NSLS-II/nsls2em-fpga/doc/xbpm_picozed_revD_sch.pdf

# Channel A

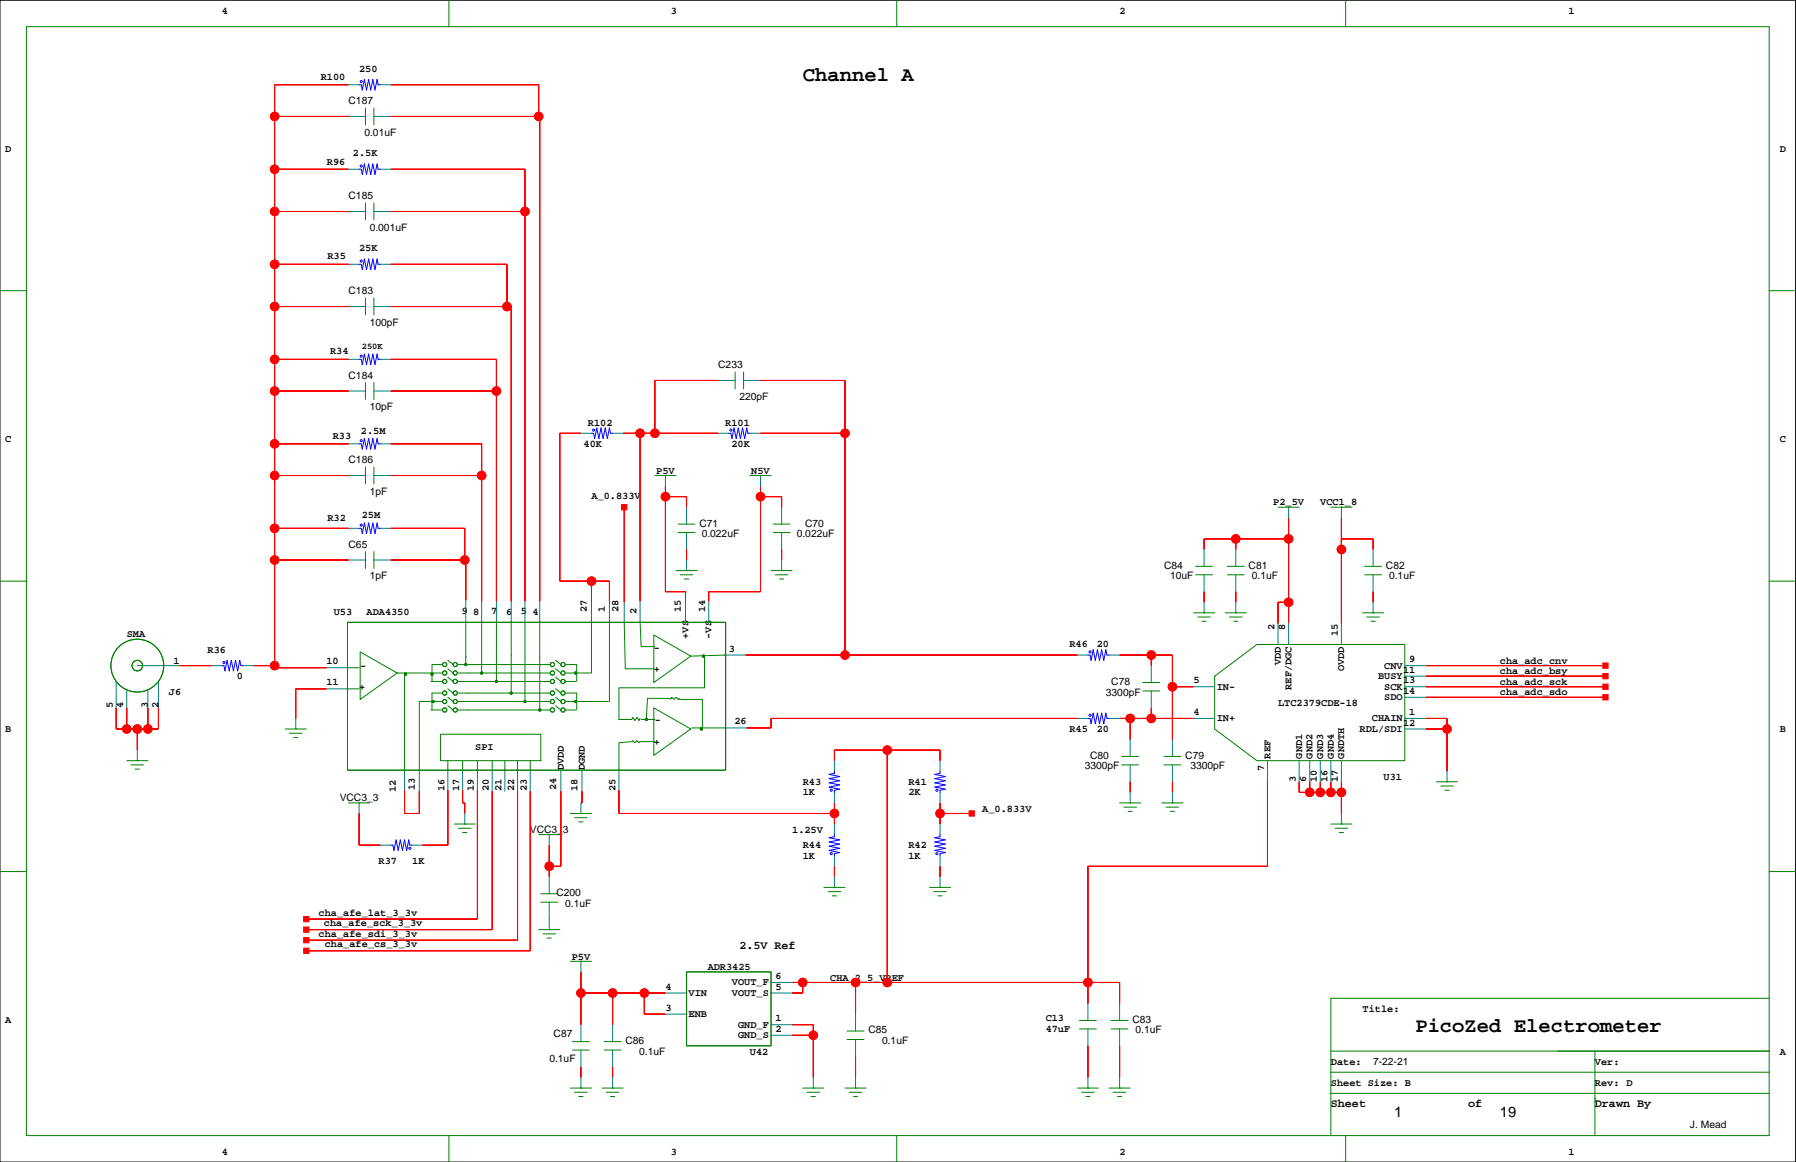
[picture p9: page 1]

Date: 7-22-21 | Ver:

Sheet Size: B | Rev: D
Sheet of | Drawn By J. Mead

# Channel B

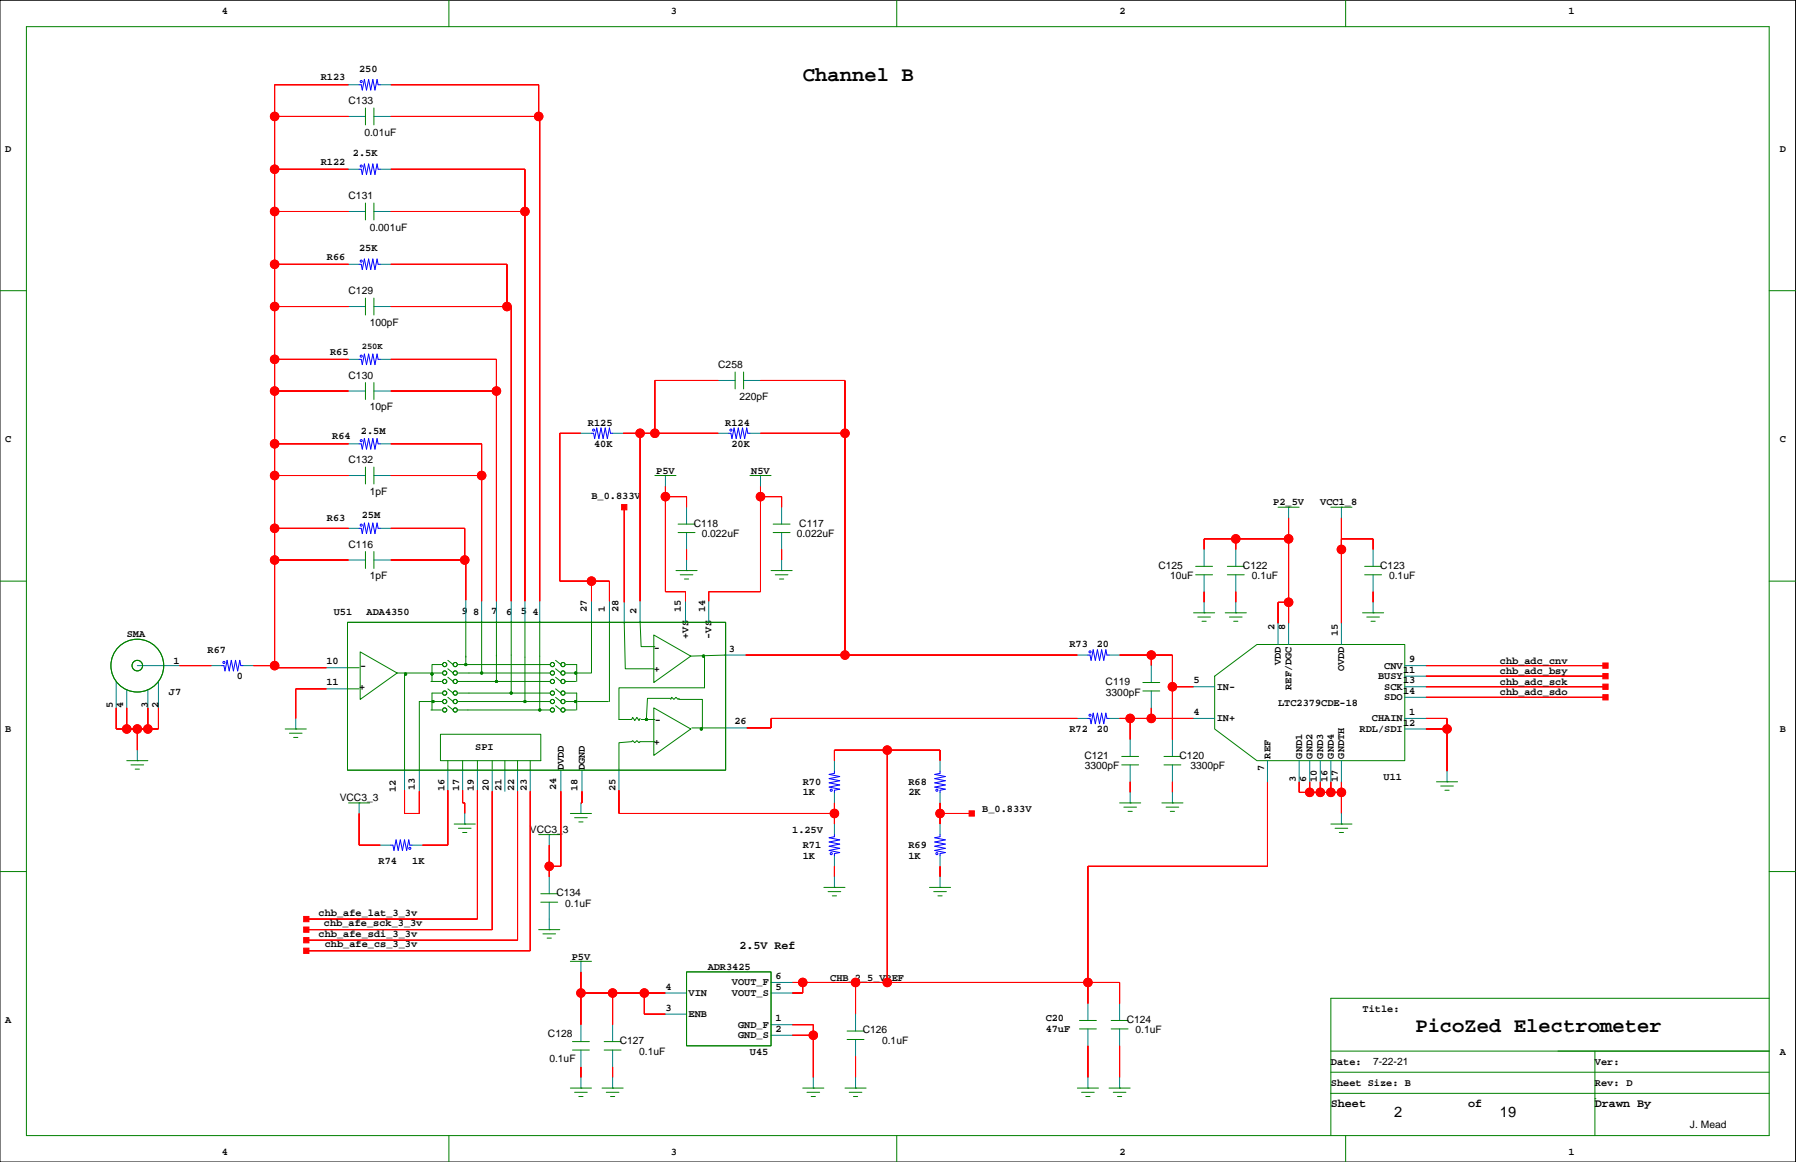
[picture p10: page 2]

# Channel C

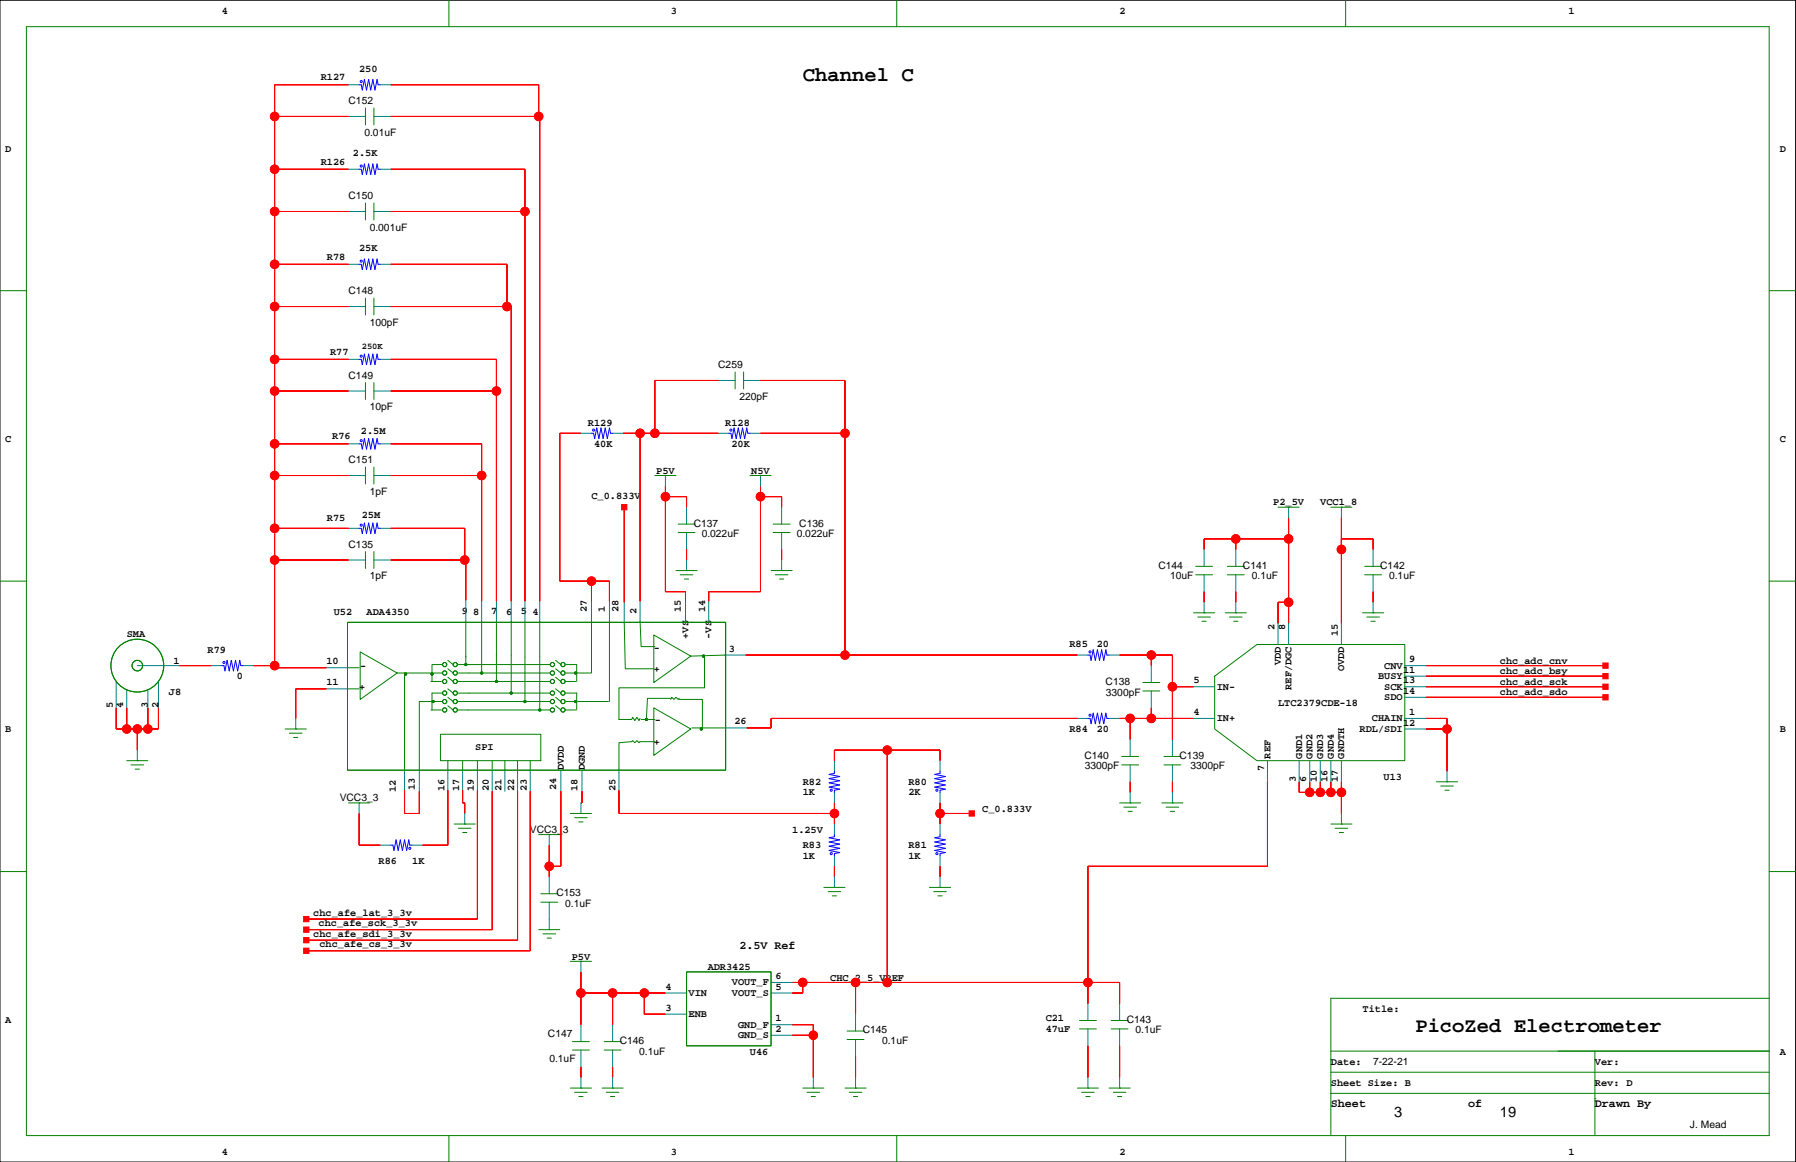
[picture p11: page 3]

# Channel D

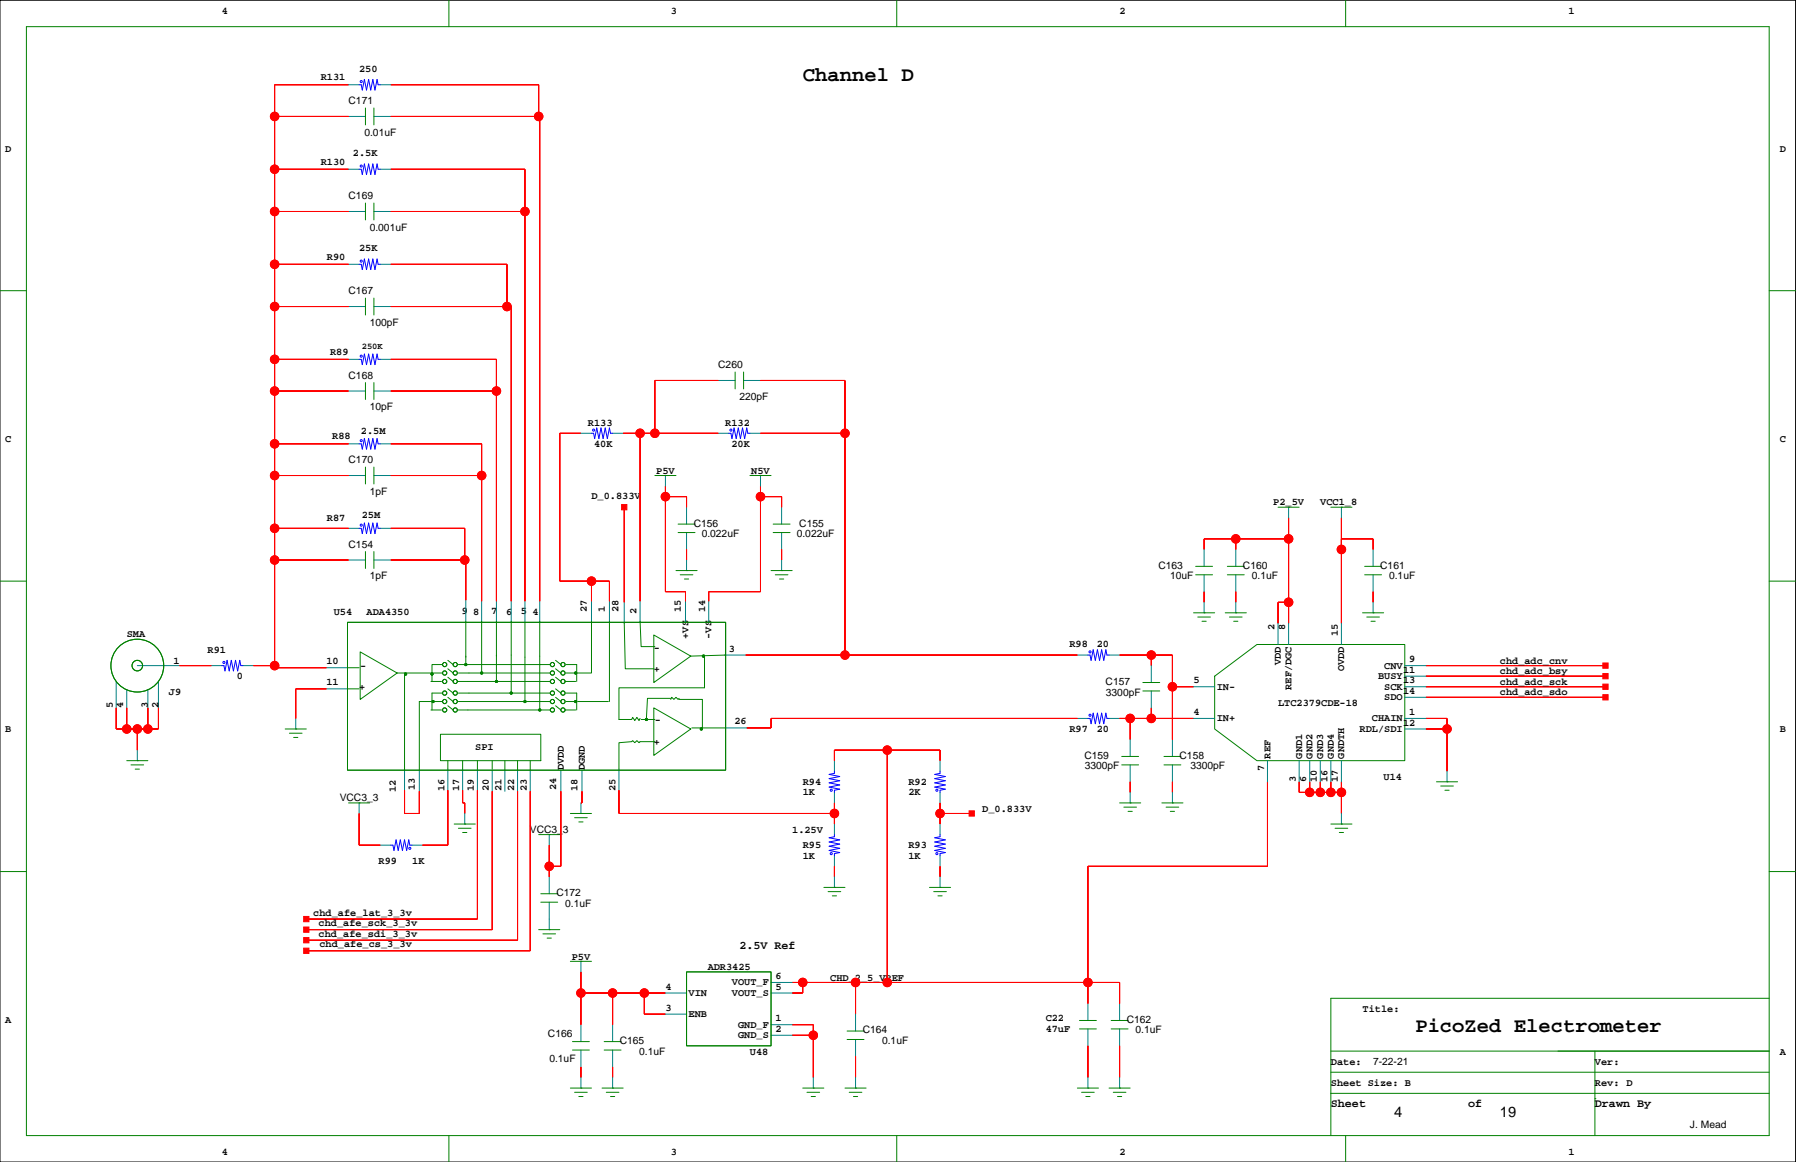
[picture p12: page 4]

# Expansion Connector

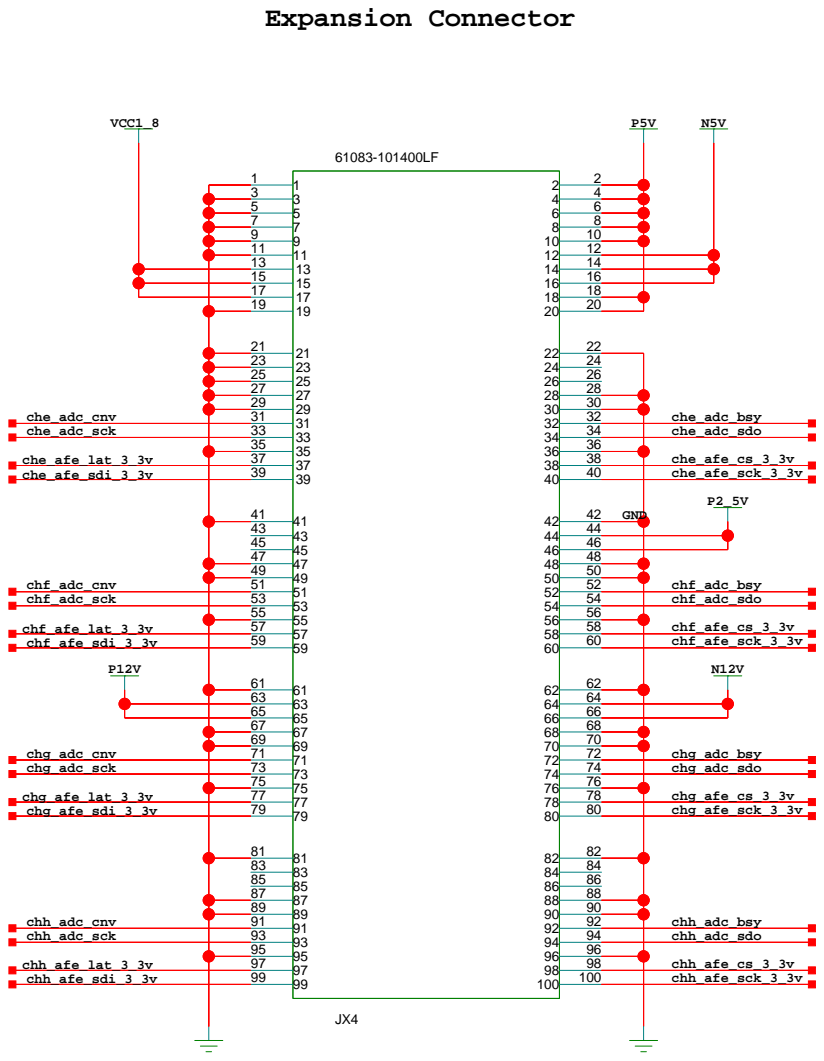
[picture p13: page 5]
Ver:; ABCD; DCBA; Title:; Date:; VCC1_8; che_adc_bsy che_adc_sdo; che_afe_cs_3_3v; che_afe_sdi_3_3v; che_afe_sck_3_3v; che_afe_lat_3_3v; che_adc_sck; che_adc_cnv; chf_afe_lat_3_3v chf_afe_sdi_3_3v; chf_adc_sck; chf_adc_cnv; chg_afe_sdi_3_3v; chg_afe_lat_3_3v; chg_adc_sck; chg_adc_cnv; chh_afe_sdi_3_3v; chh_afe_lat_3_3v; chh_adc_sck; chh_adc_cnv; chf_afe_sck_3_3v; chf_afe_cs_3_3v; chf_adc_sdo; chf_adc_bsy; chg_afe_sck_3_3v; chg_afe_cs_3_3v; chg_adc_sdo; chg_adc_bsy; chh_afe_sck_3_3v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

# 3.3v to 1.8v level translator

# 3.3v to 5v level translator

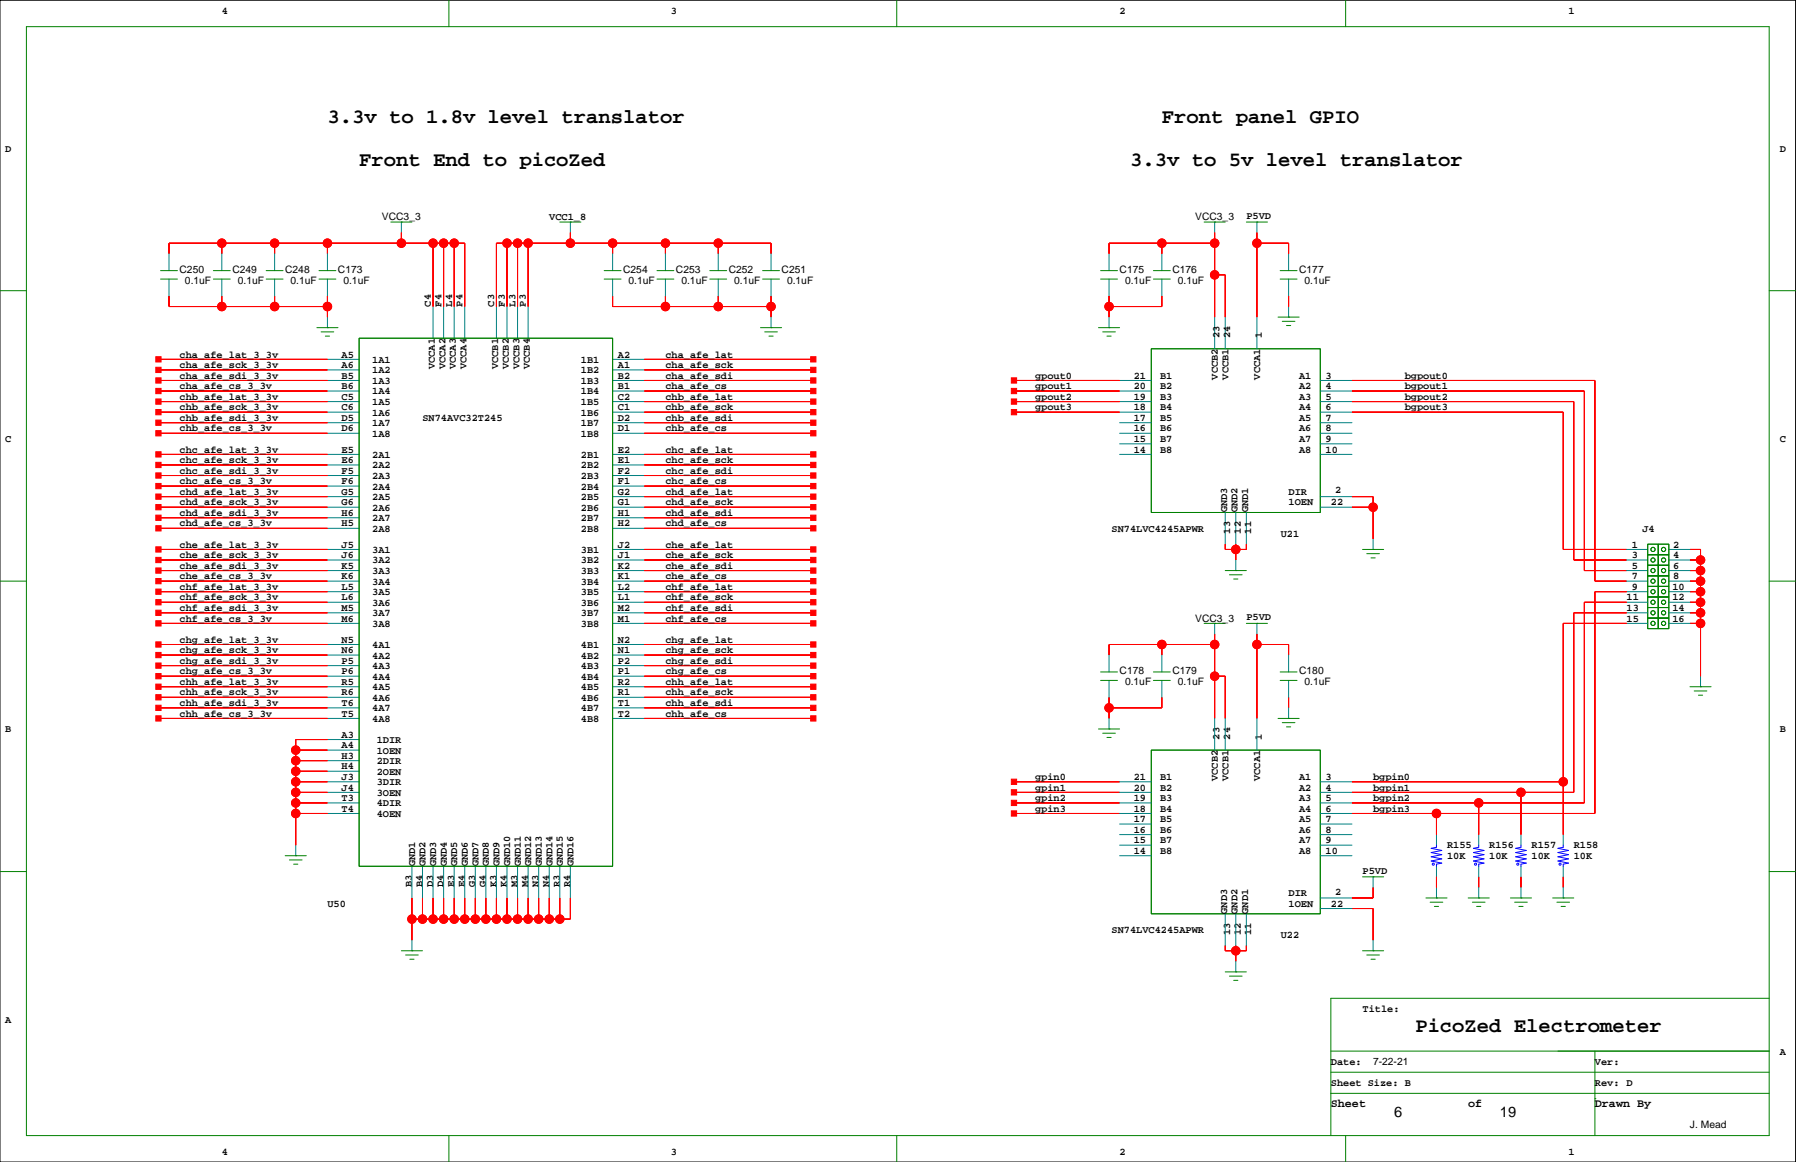
[picture p14: page 6]

Front End to picoZed

# Detector BIAS

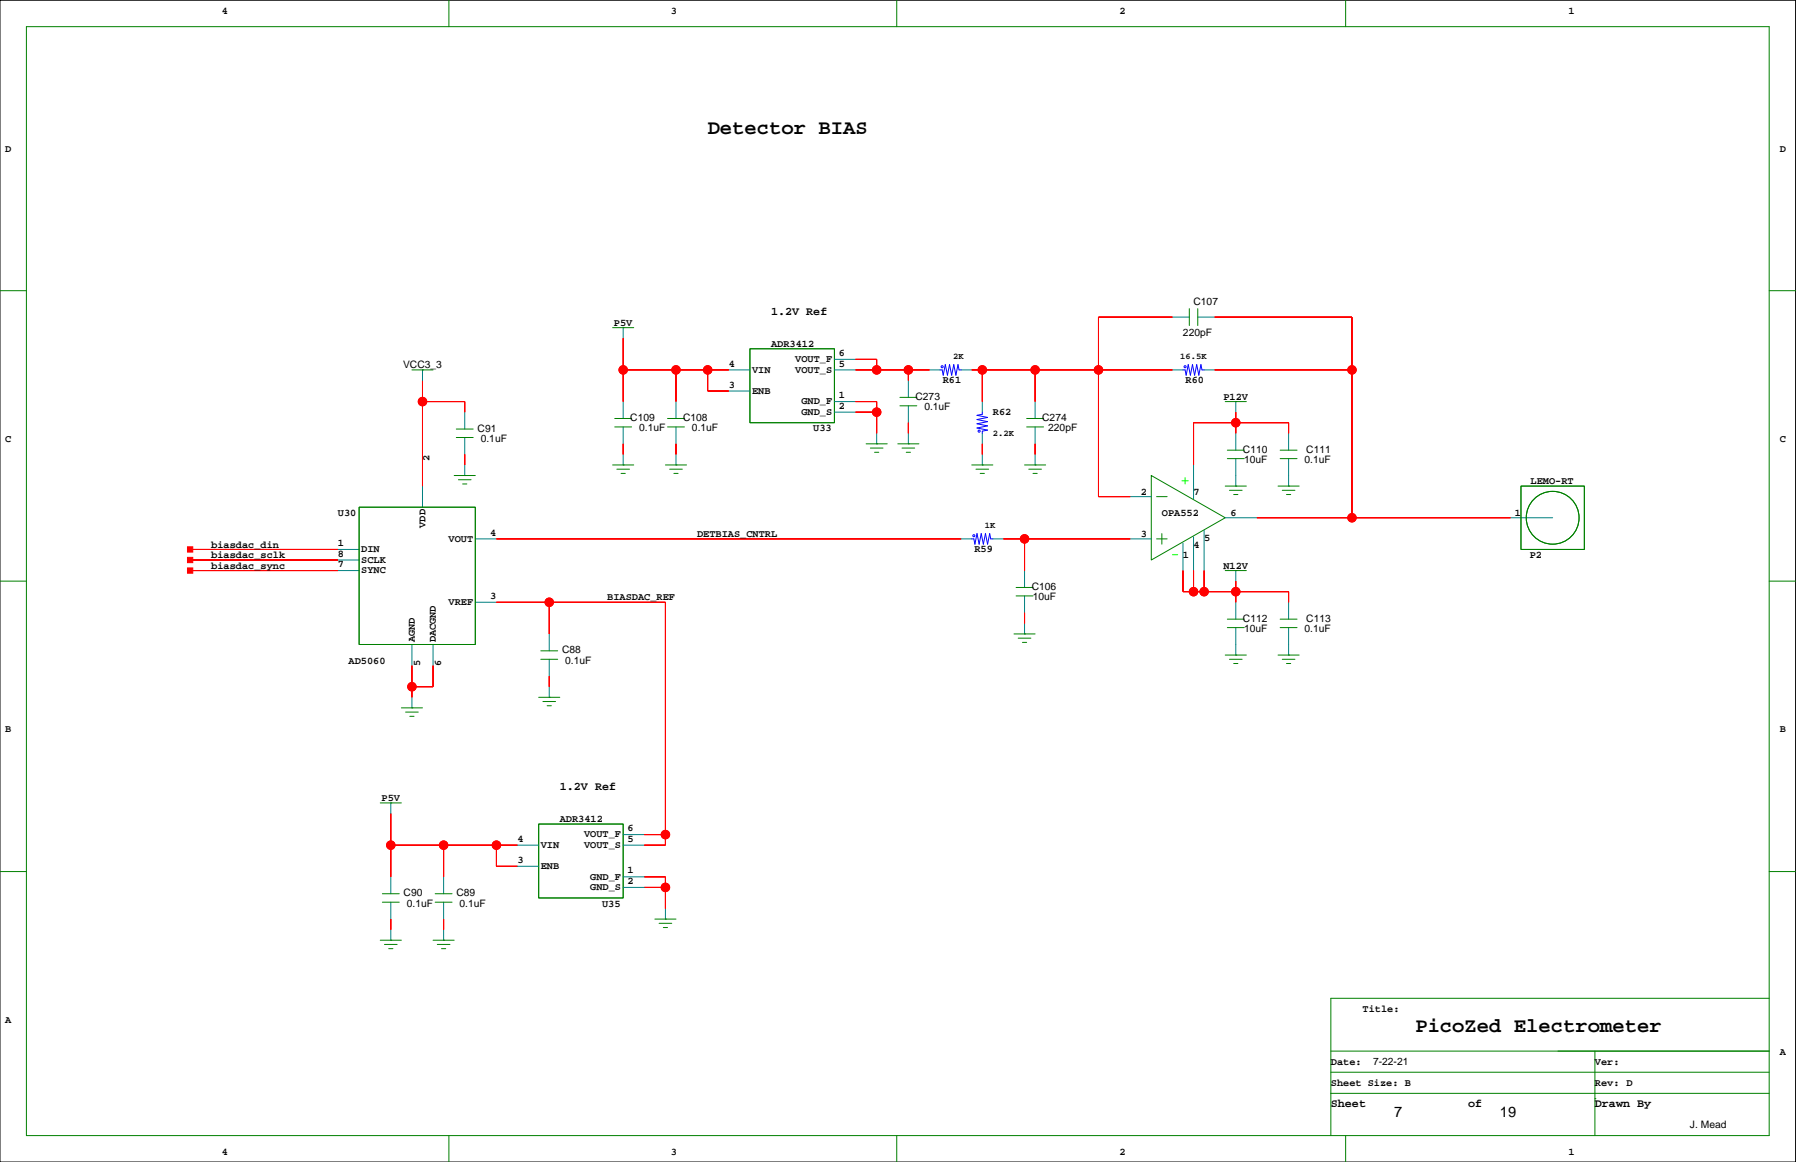
[picture p15: page 7]

# Motion Feedback DAC Outputs

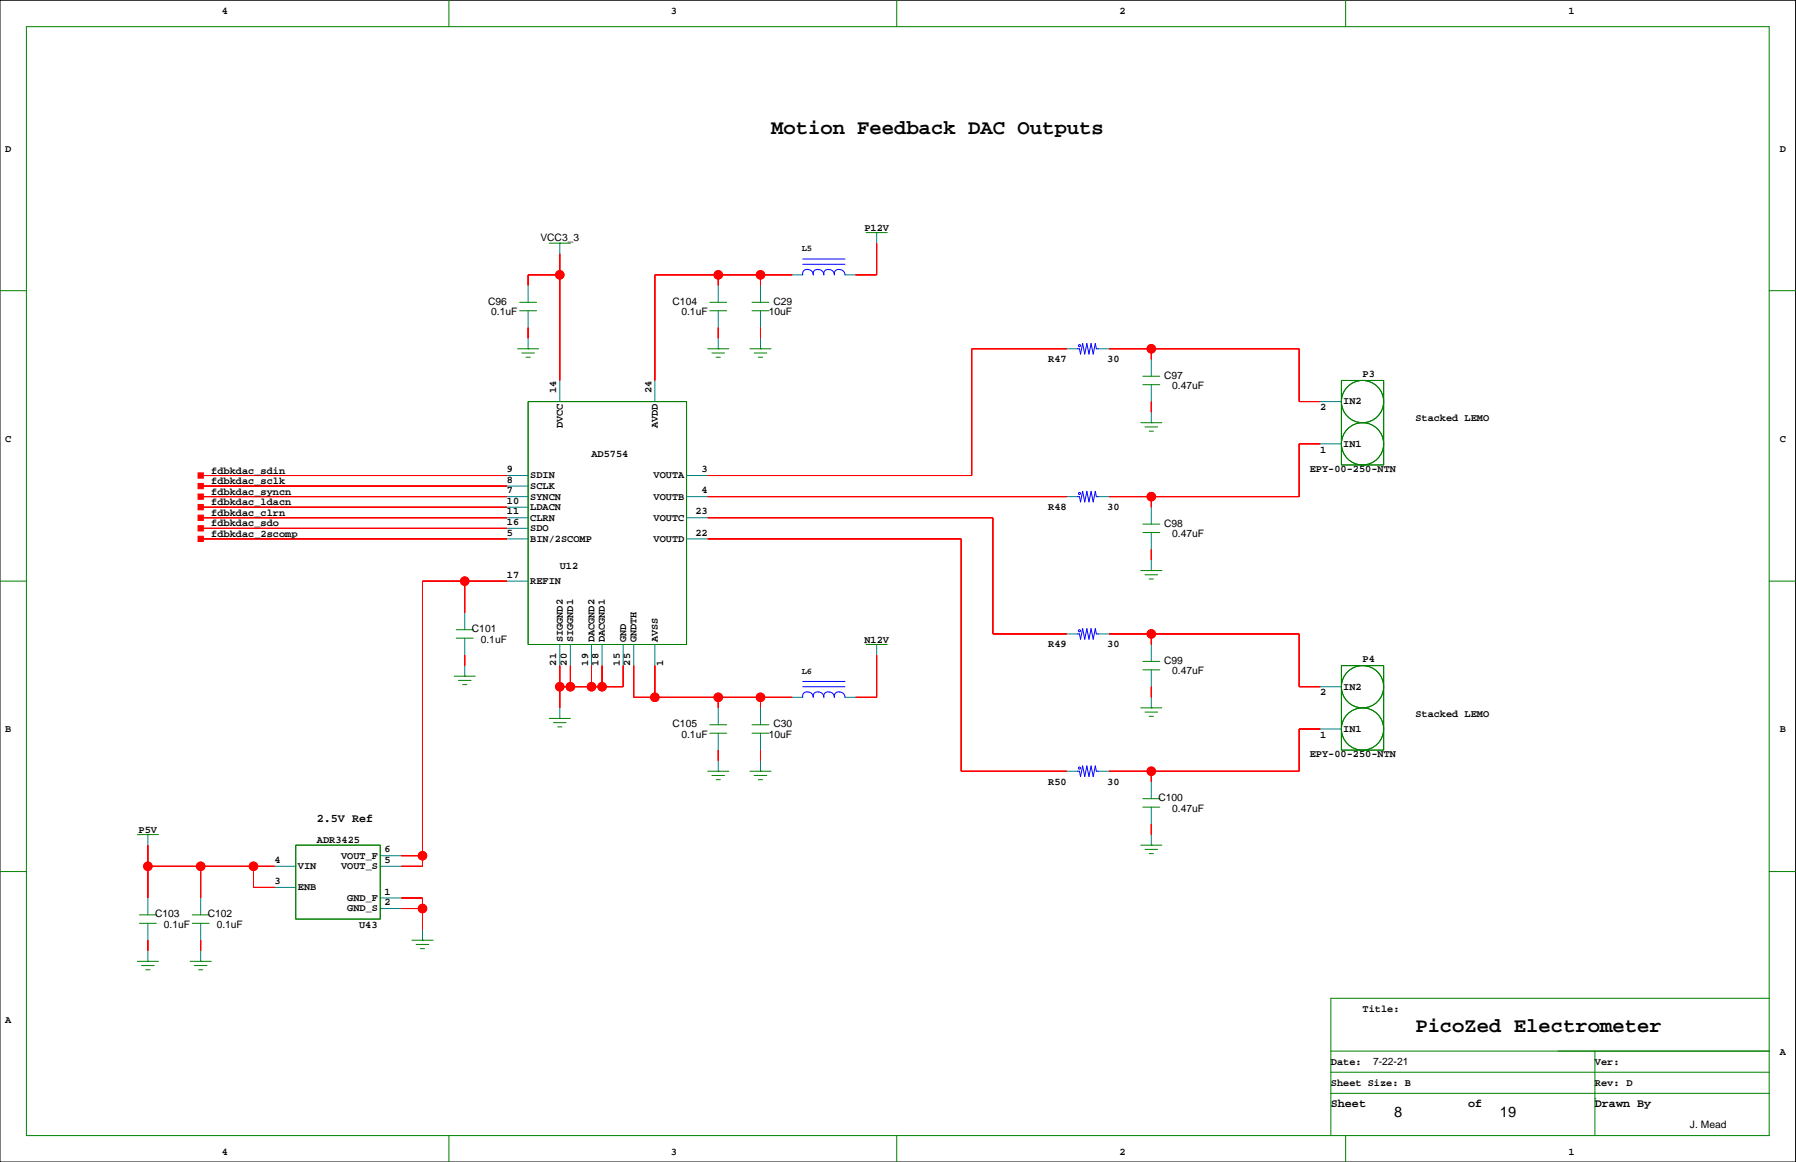
[picture p16: page 8]

# Temperature Control: Thermistor Readback

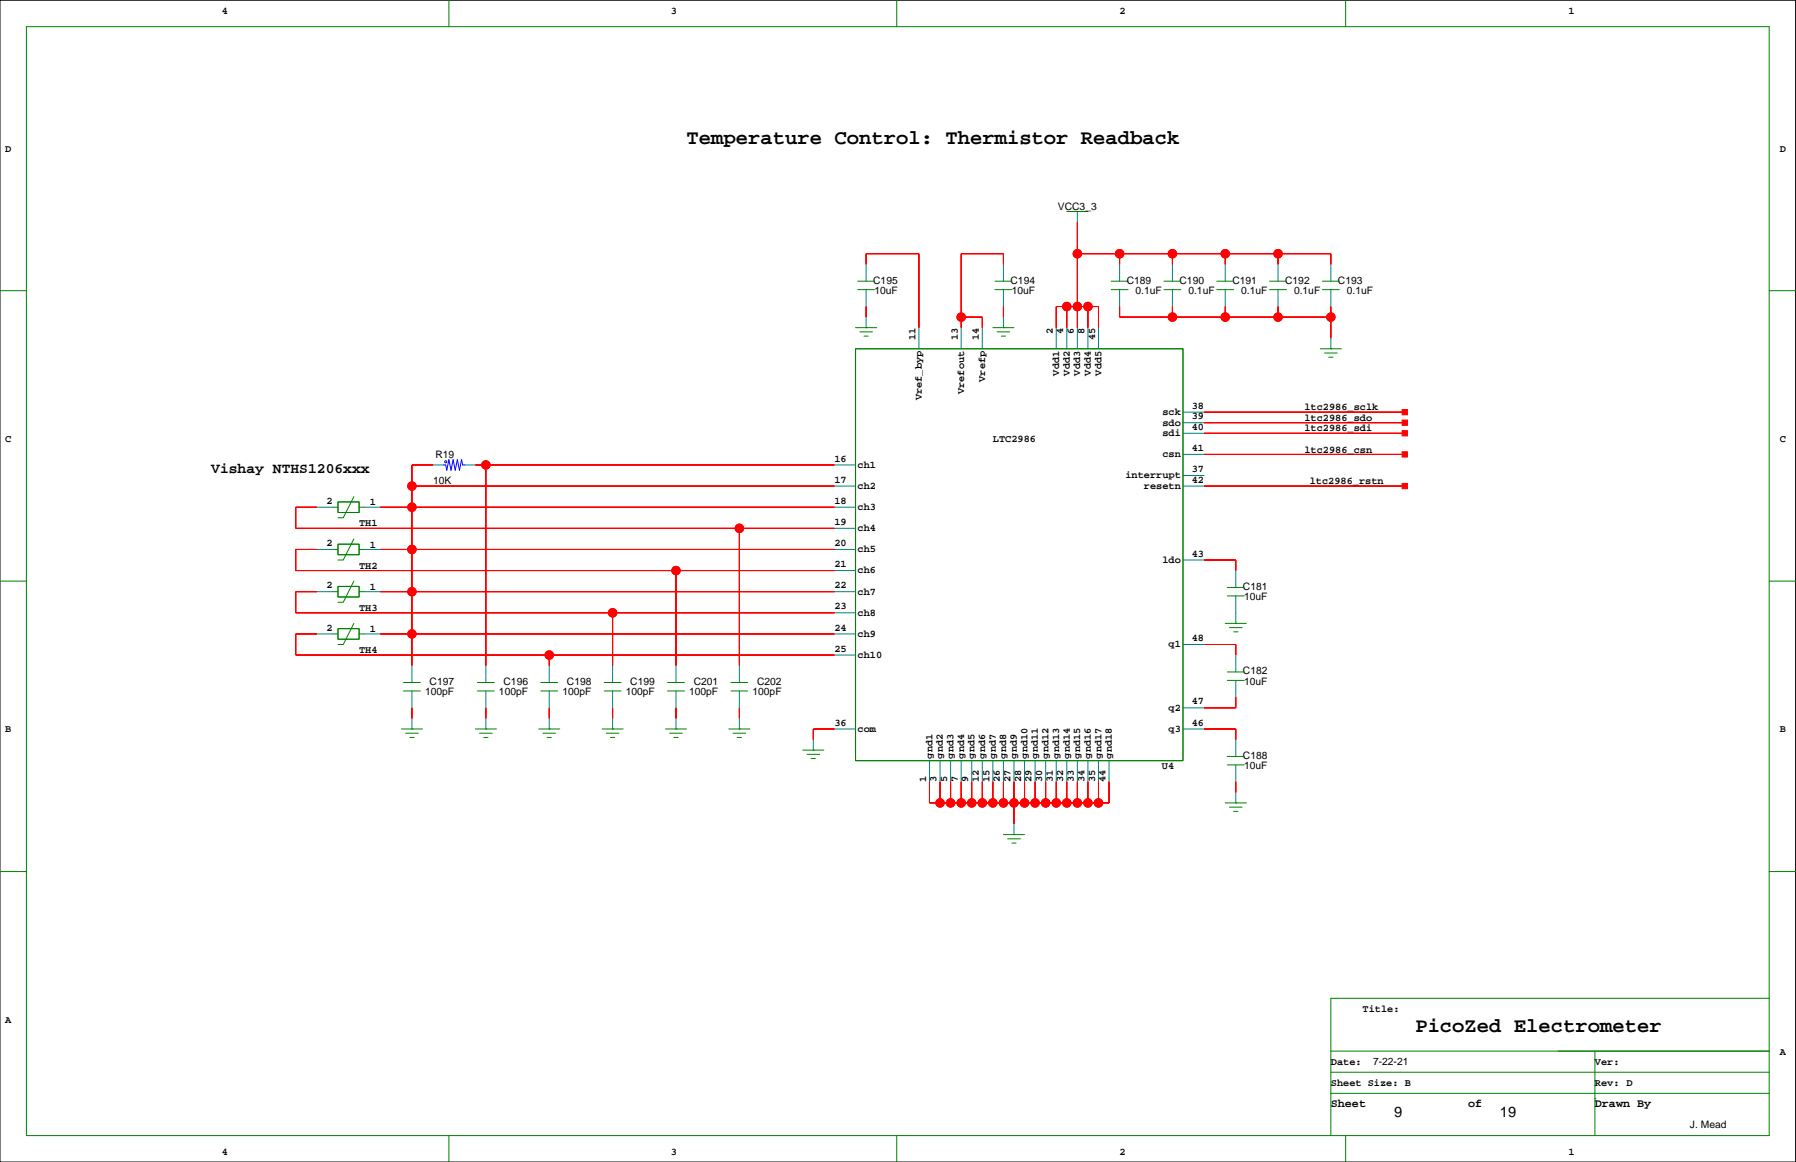
[picture p17: page 9]

# Temperature Control : DAC Outputs with Resistor Heaters

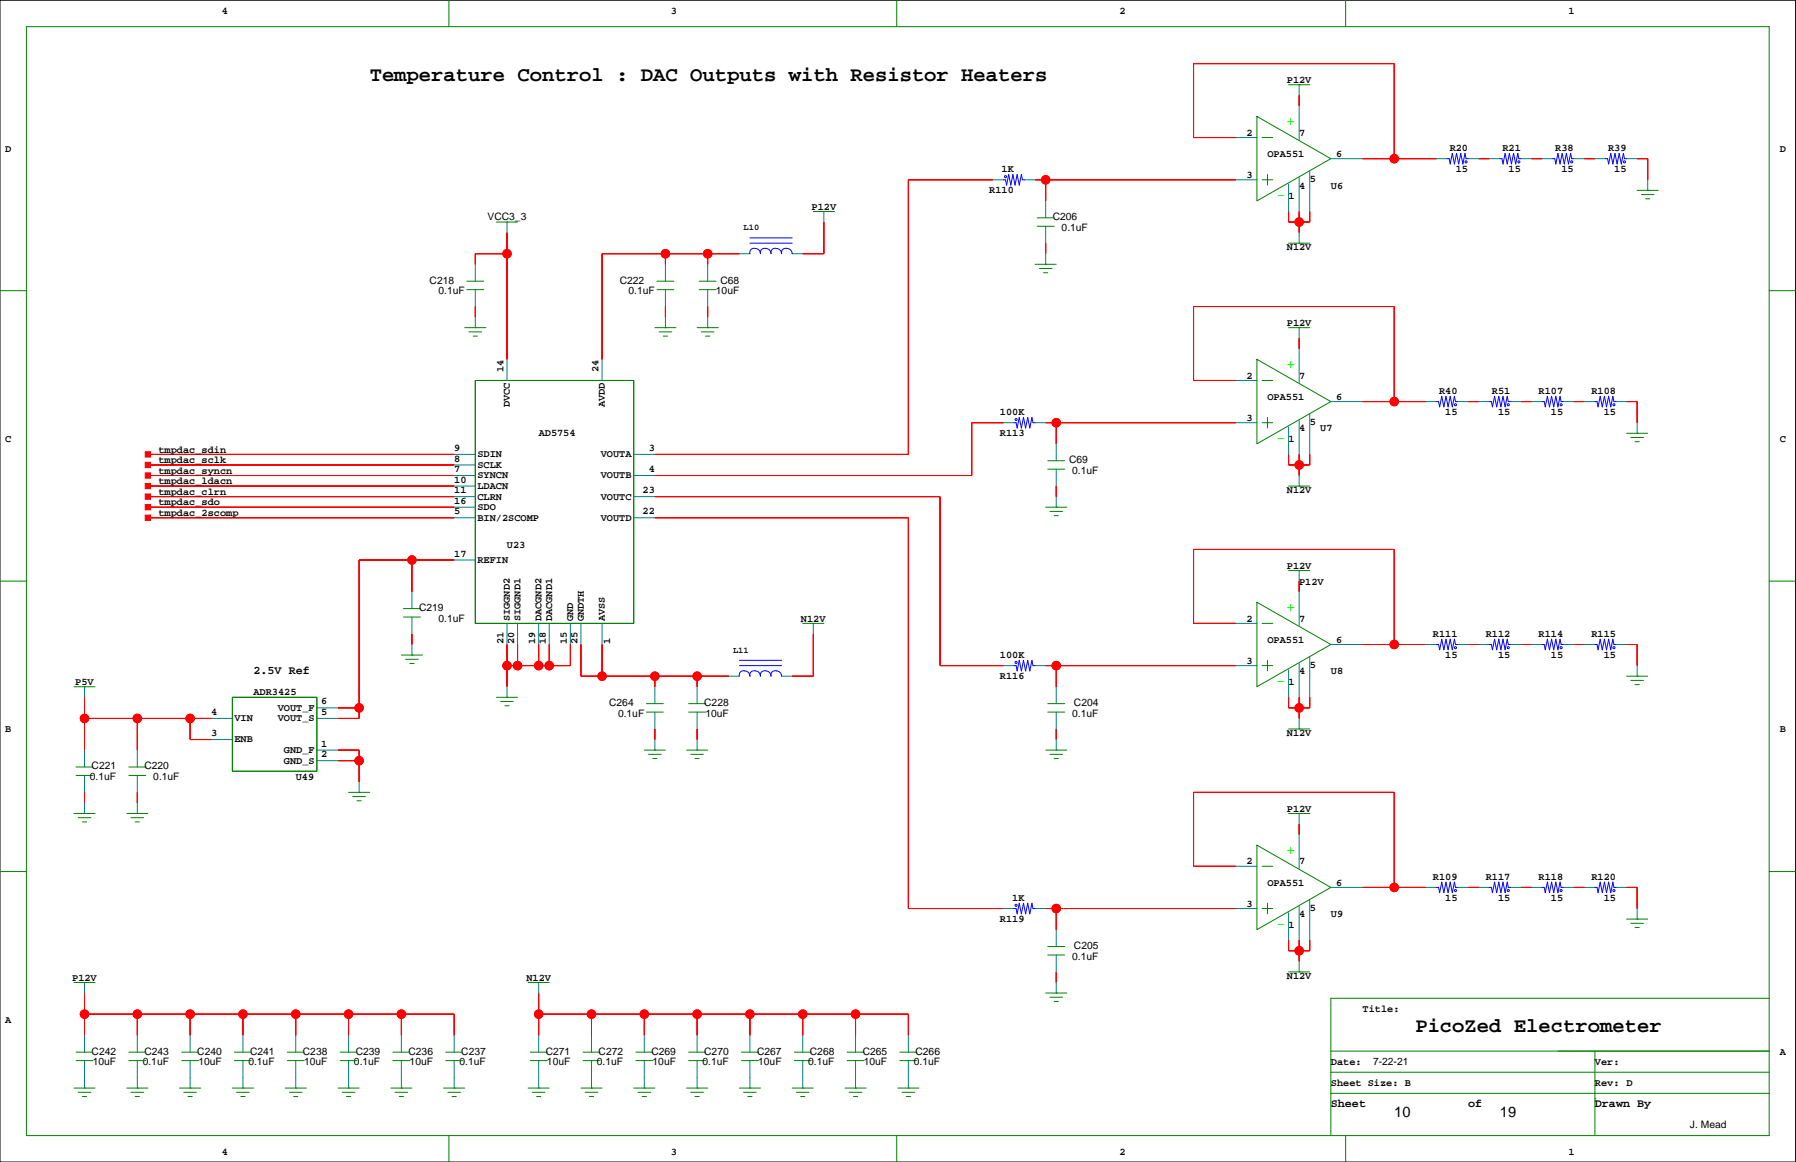
[picture p18: page 10]

# picoZED Connectors JX1 & JX2

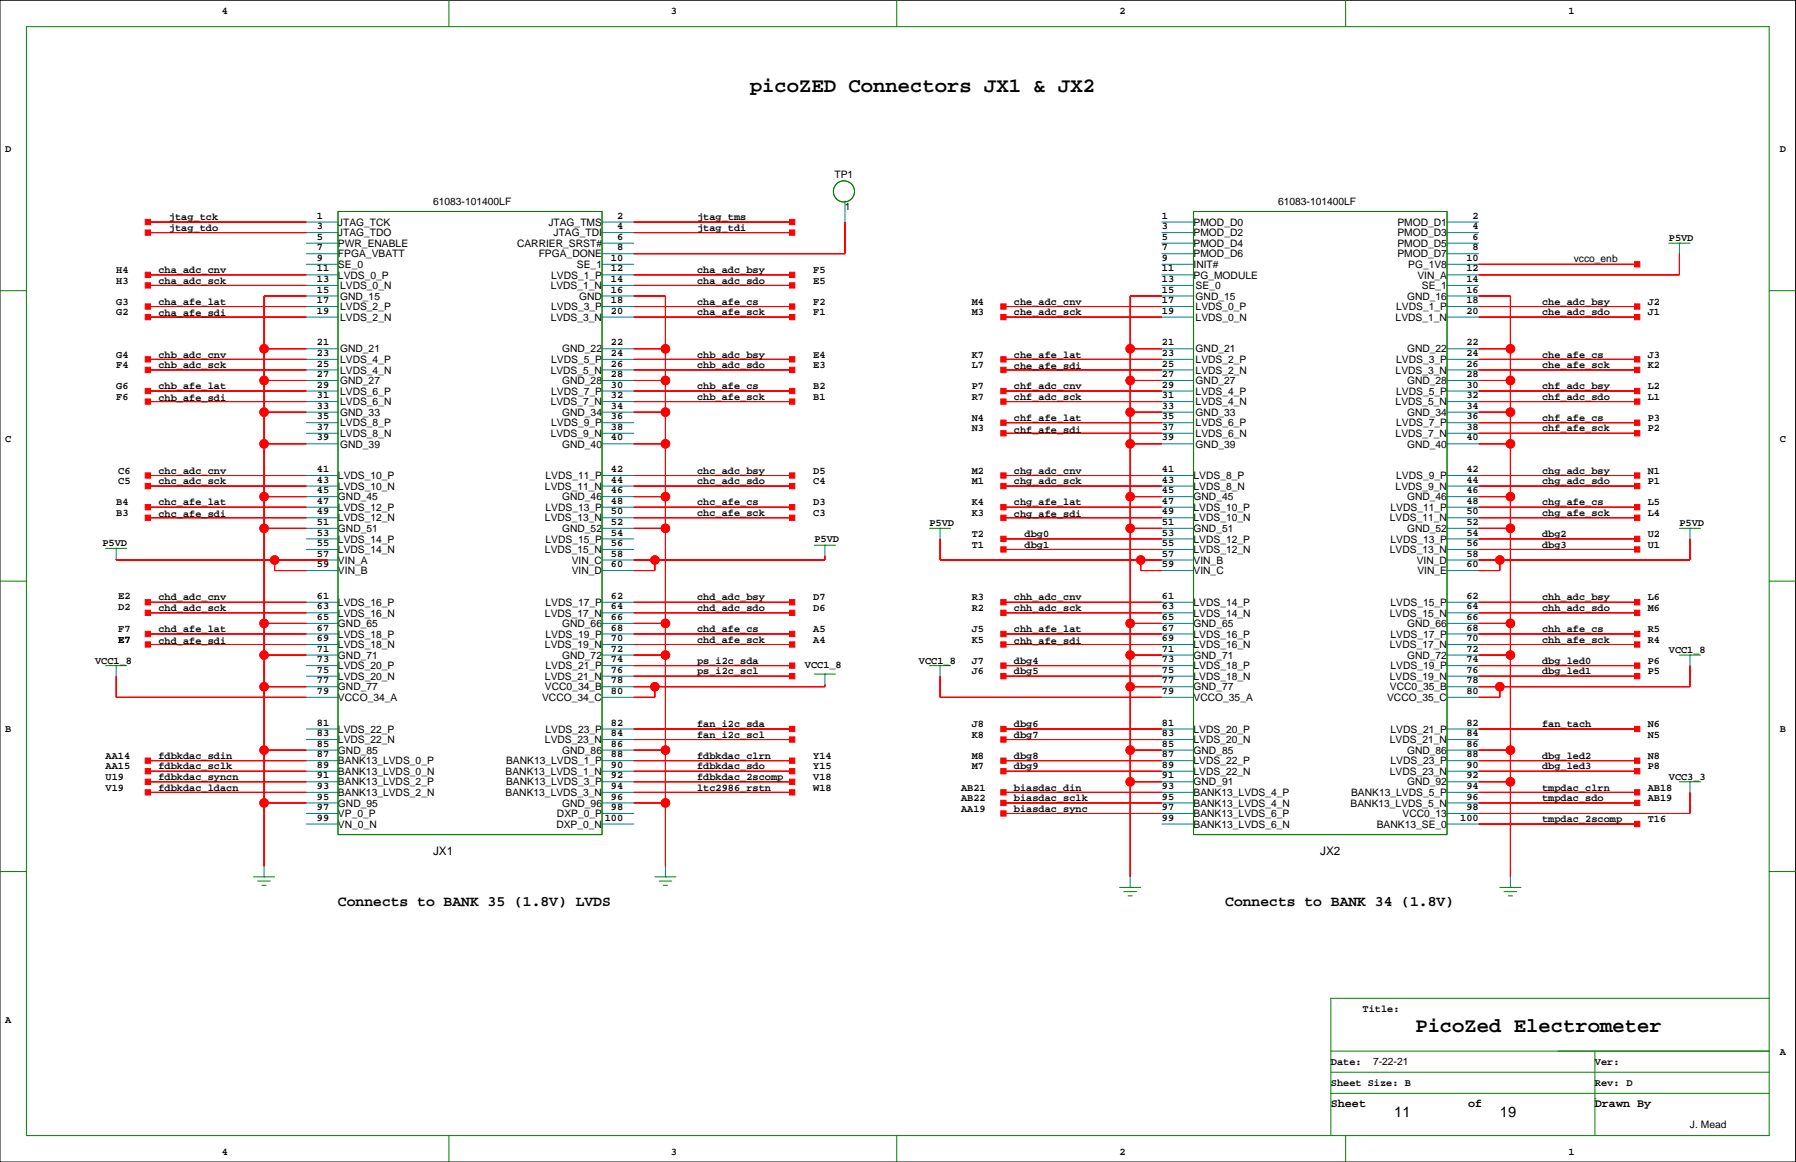
[picture p19: page 11]

# picoZED Connector JX3

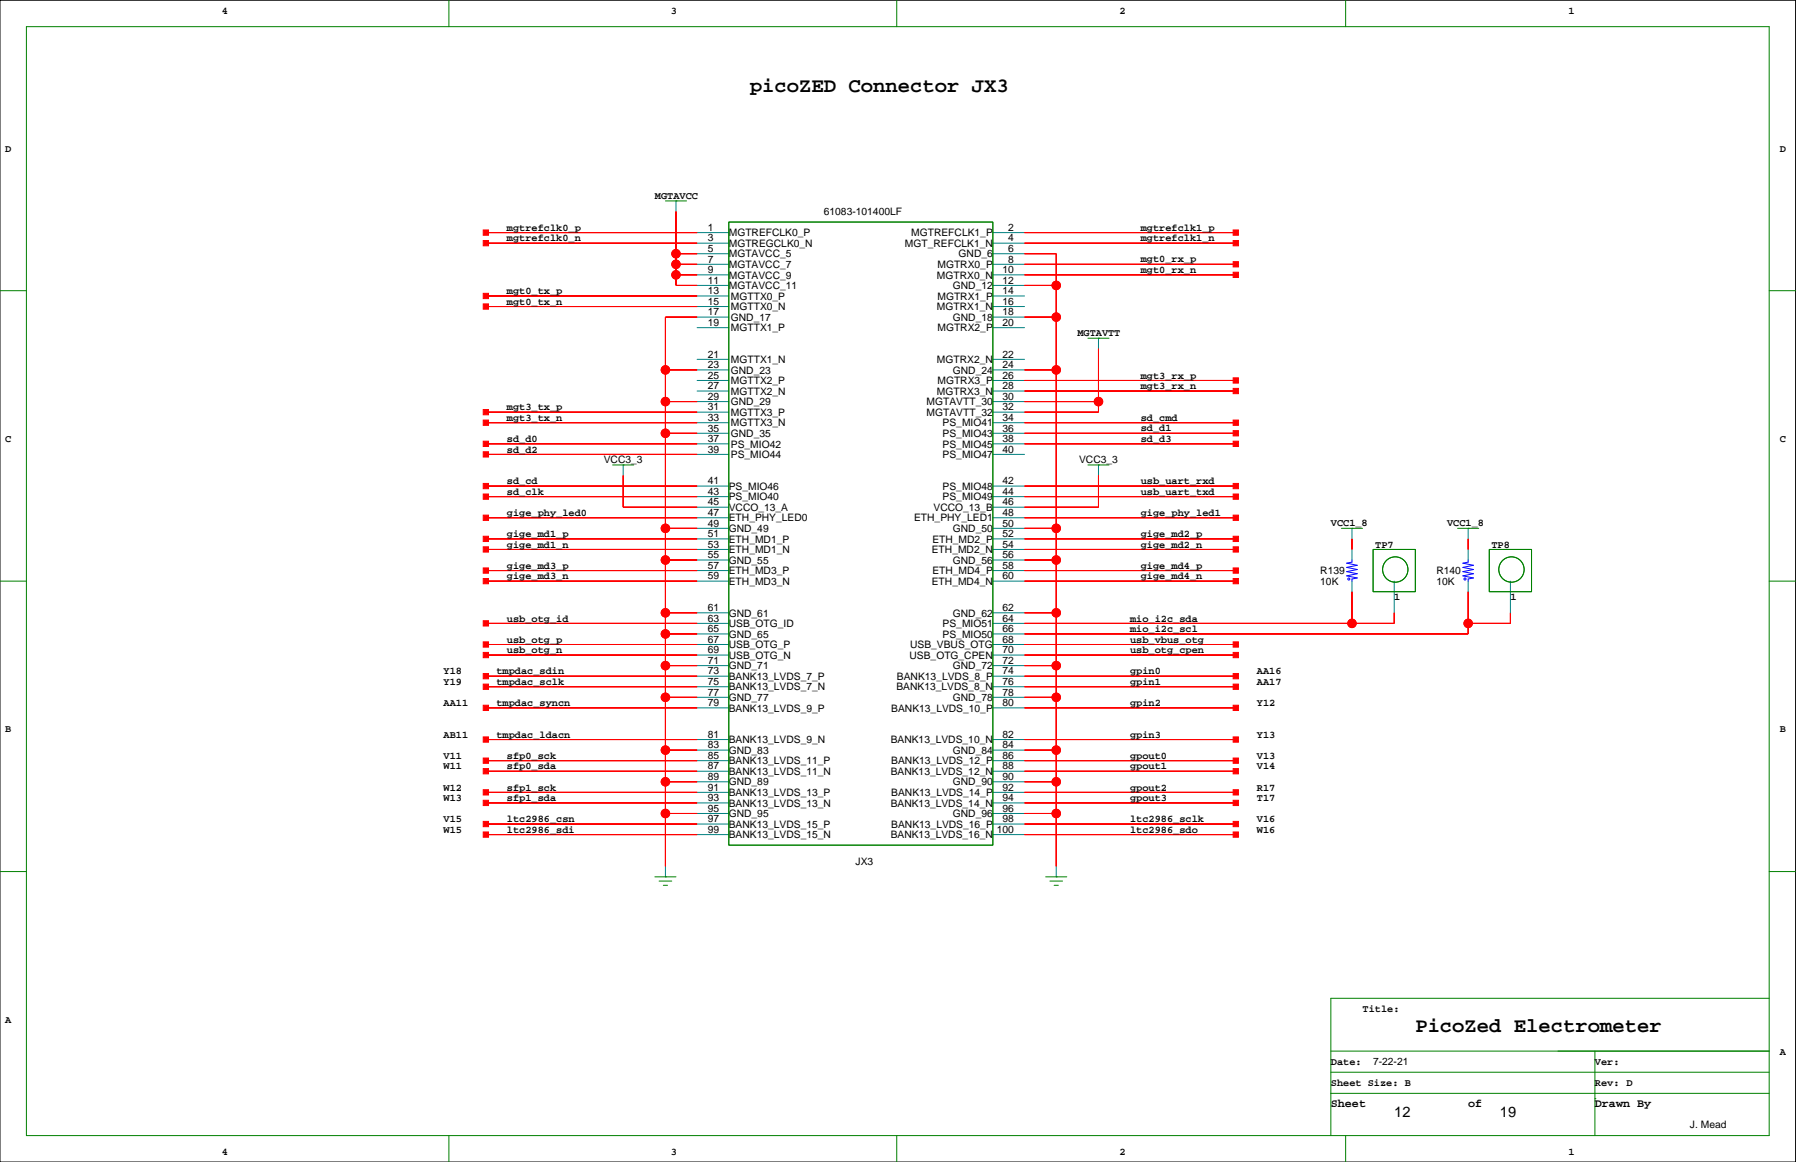
[picture p20: page 12]
MGTAVCC; MGTAVTT; VCC3_3; MGTREFCLK0_P MGTREGCLK0_N MGTAVCC_5 MGTAVCC_7 MGTAVCC_9 MGTAVCC_11 MGTTX0_P MGTTX0_N GND_17 MGTTX1_P; MGTTX1_N GND_23 MGTTX2_P MGTTX2_N GND_29 MGTTX3_P MGTTX3_N GND_35 PS_MIO42 PS_MIO44; MGTREFCLK1_P MGT_REFCLK1_N GND_6 MGTRX0_P MGTRX0_N GND_12 MGTRX1_P MGTRX1_N GND_18 MGTRX2_P; MGTRX2_N GND_24 MGTRX3_P MGTRX3_N MGTAVTT_30 MGTAVTT_32 PS_MIO41 PS_MIO43 PS_MIO45 PS_MIO47; PS_MIO46 PS_MIO40 VCCO_13_A ETH_PHY_LED0 GND_49 ETH_MD1_P ETH_MD1_N GND_55 ETH_MD3_P ETH_MD3_N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

# +12v Input

# VI Readback

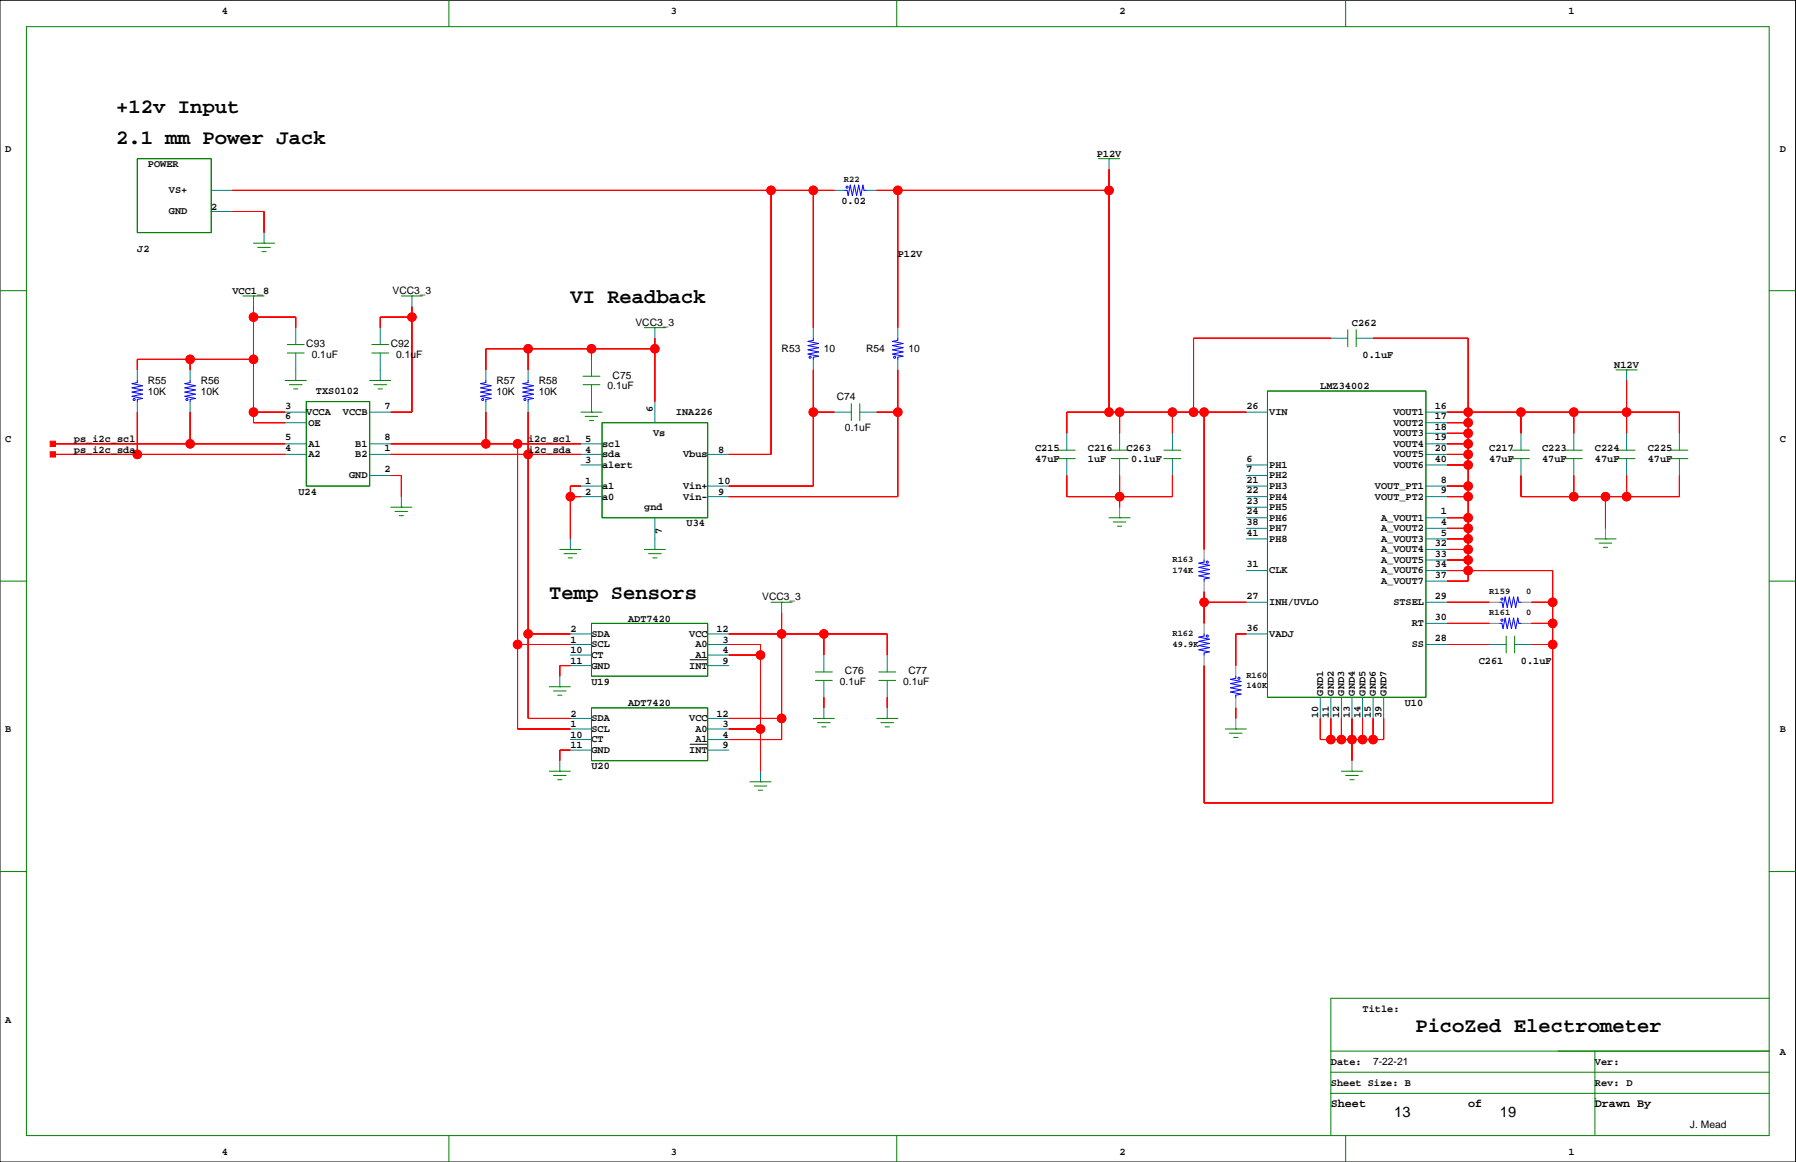
[picture p21: page 13]

### VOUT RON

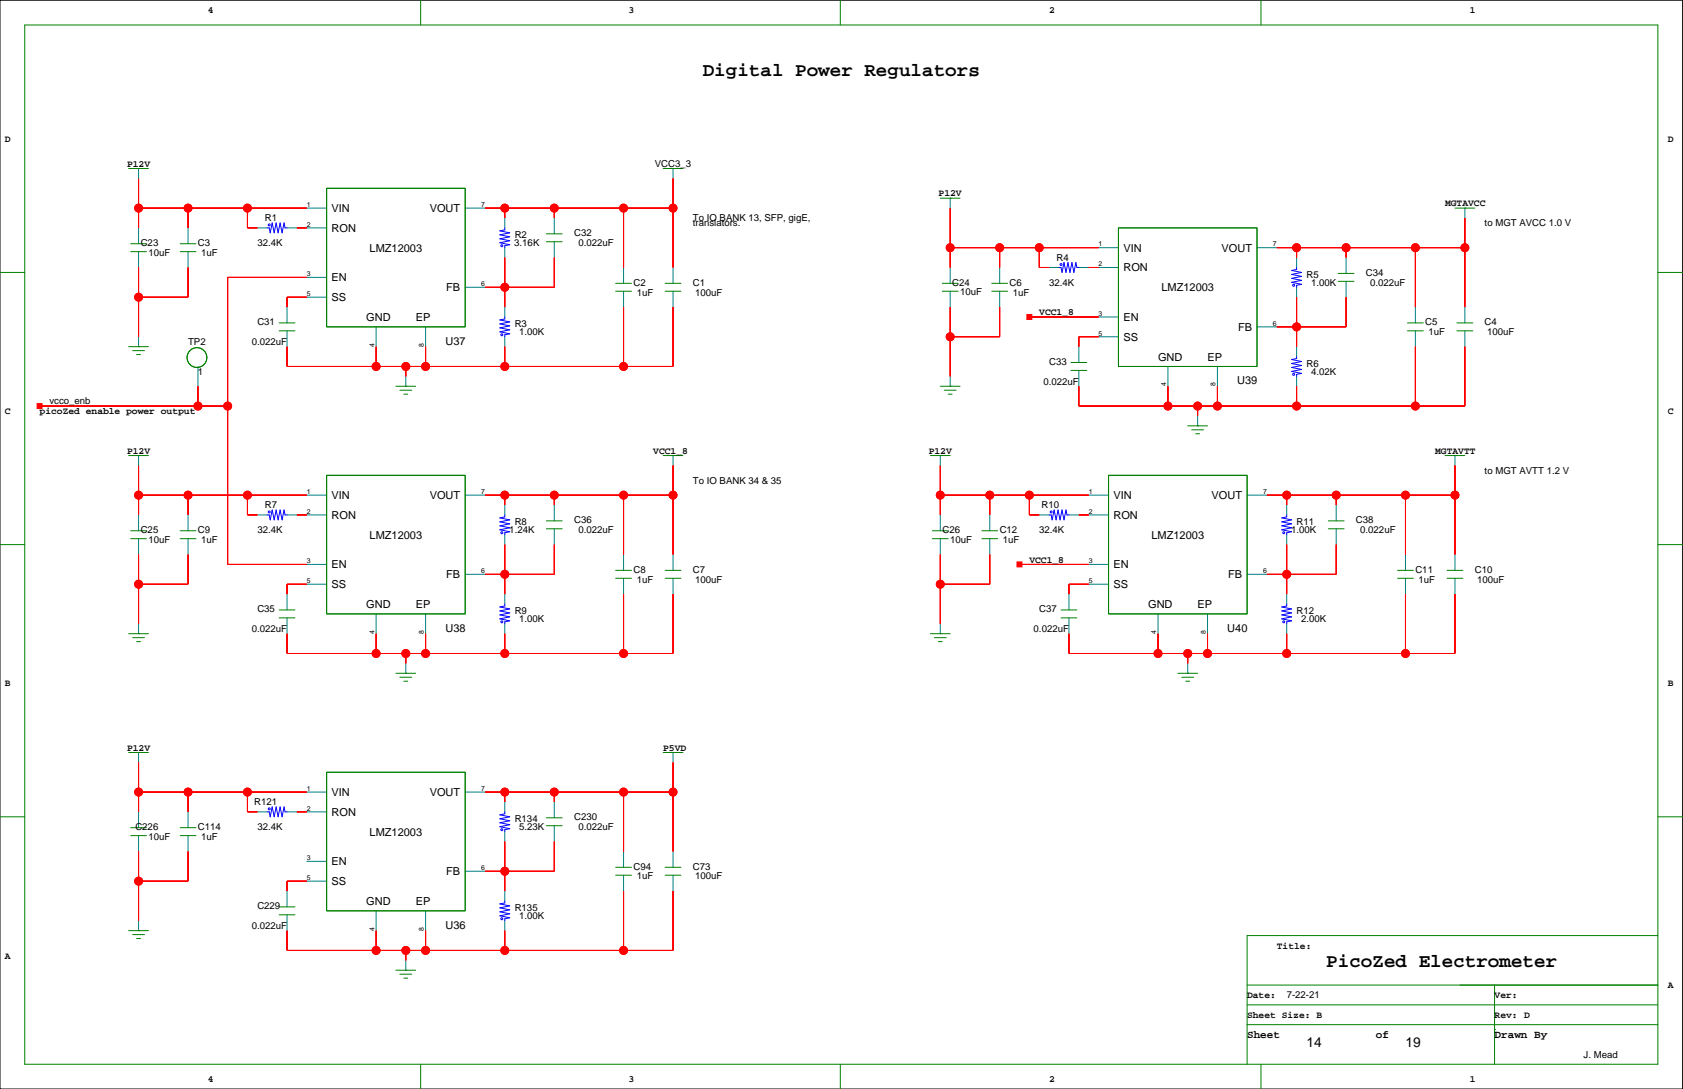
[picture p22: page 14]

To IO BANK 13, SFP, gigE, translators.

vcco_enb
picoZed enable power output

# Front End Regulators

### VOUT

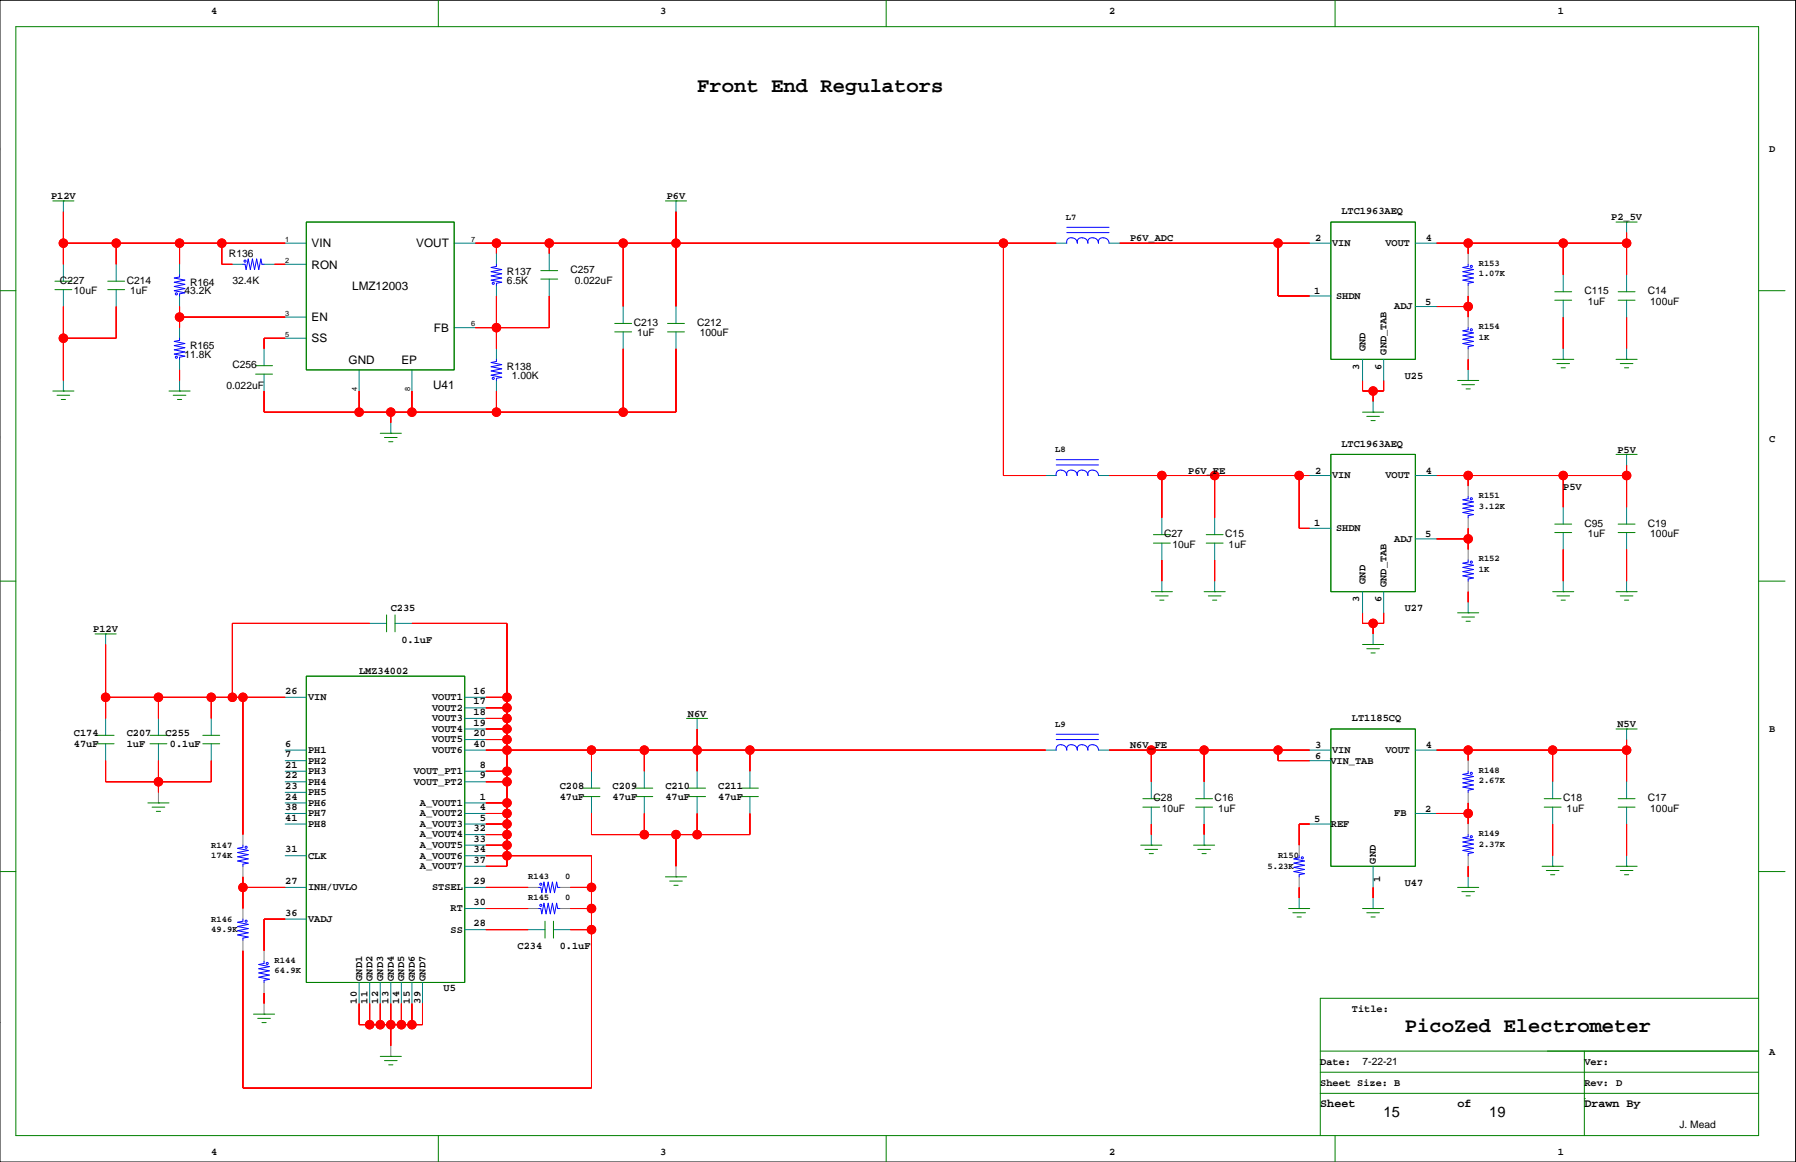
[picture p23: page 15]

# JTAG Header

# Miscellaneous

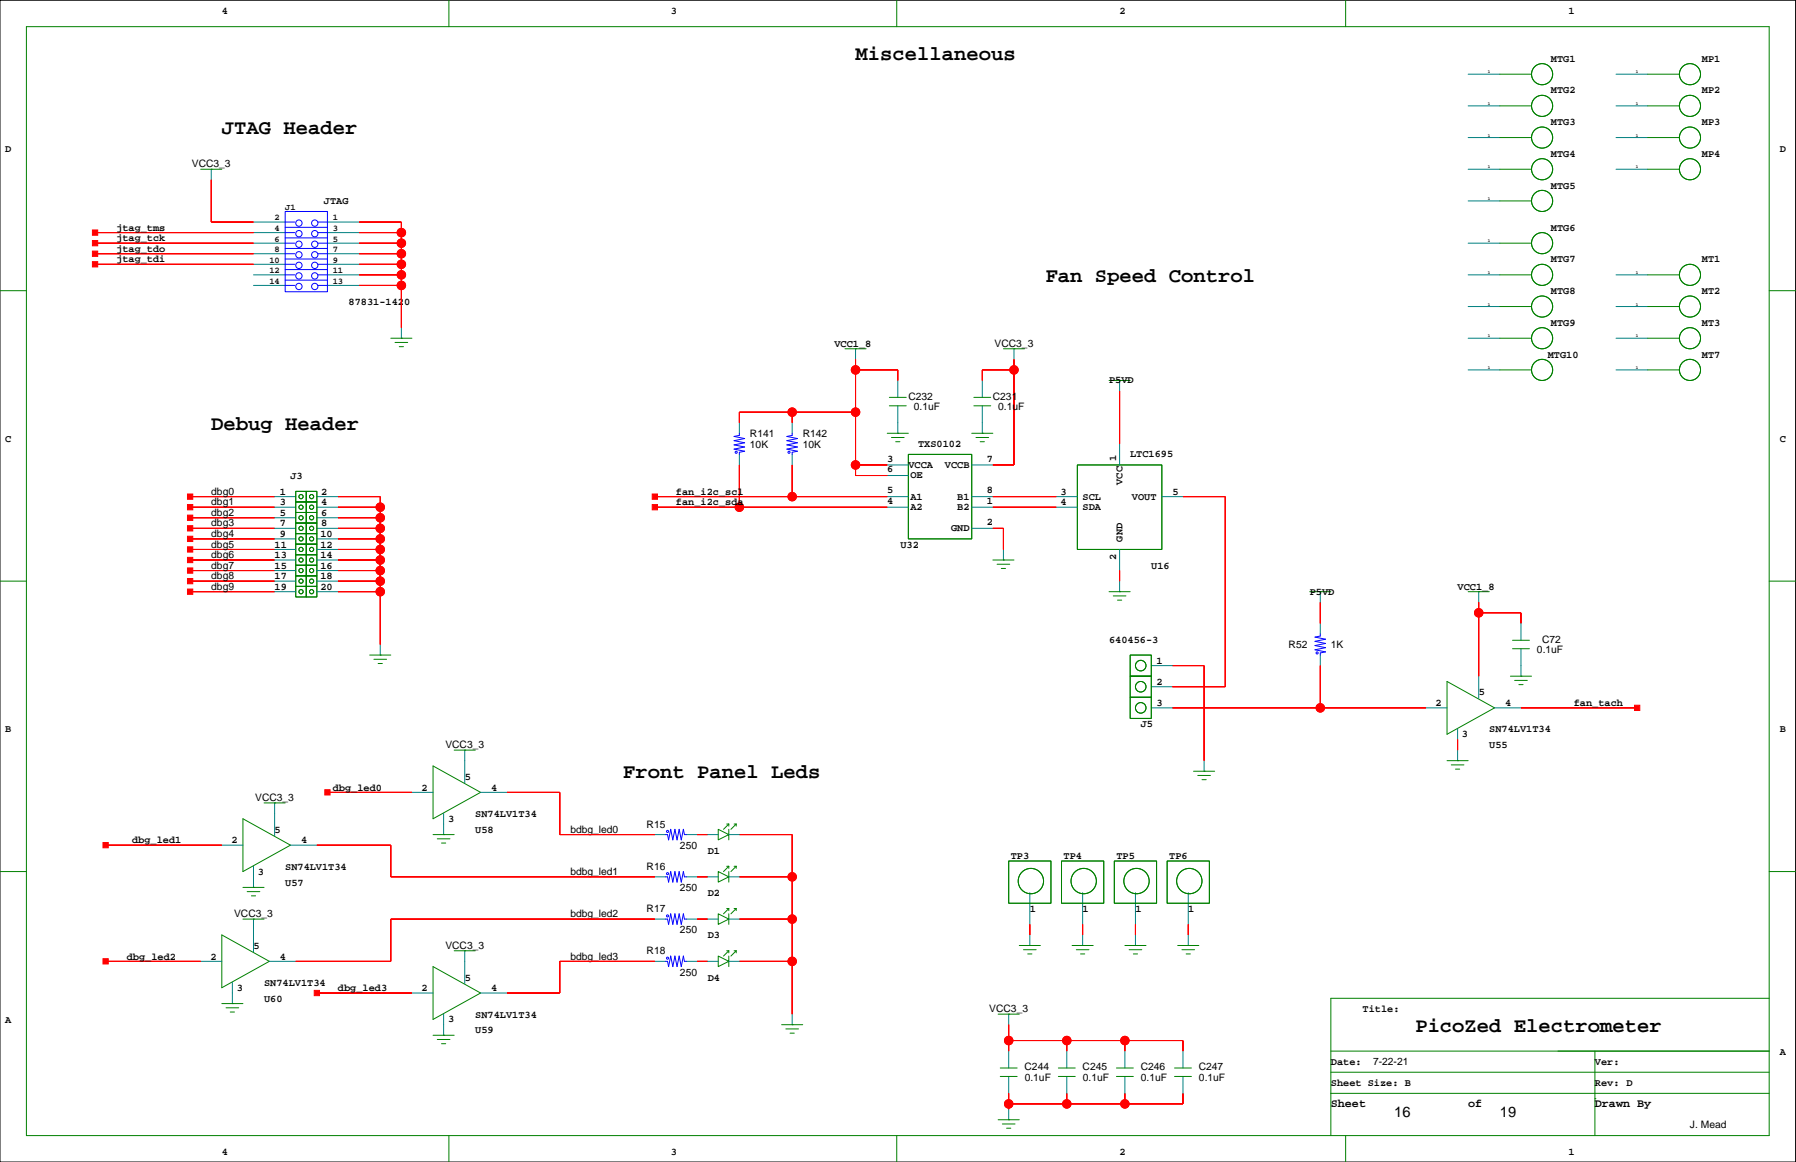
[picture p24: page 16]

# SFP Connecters

Event Receiver | Data Transceiver

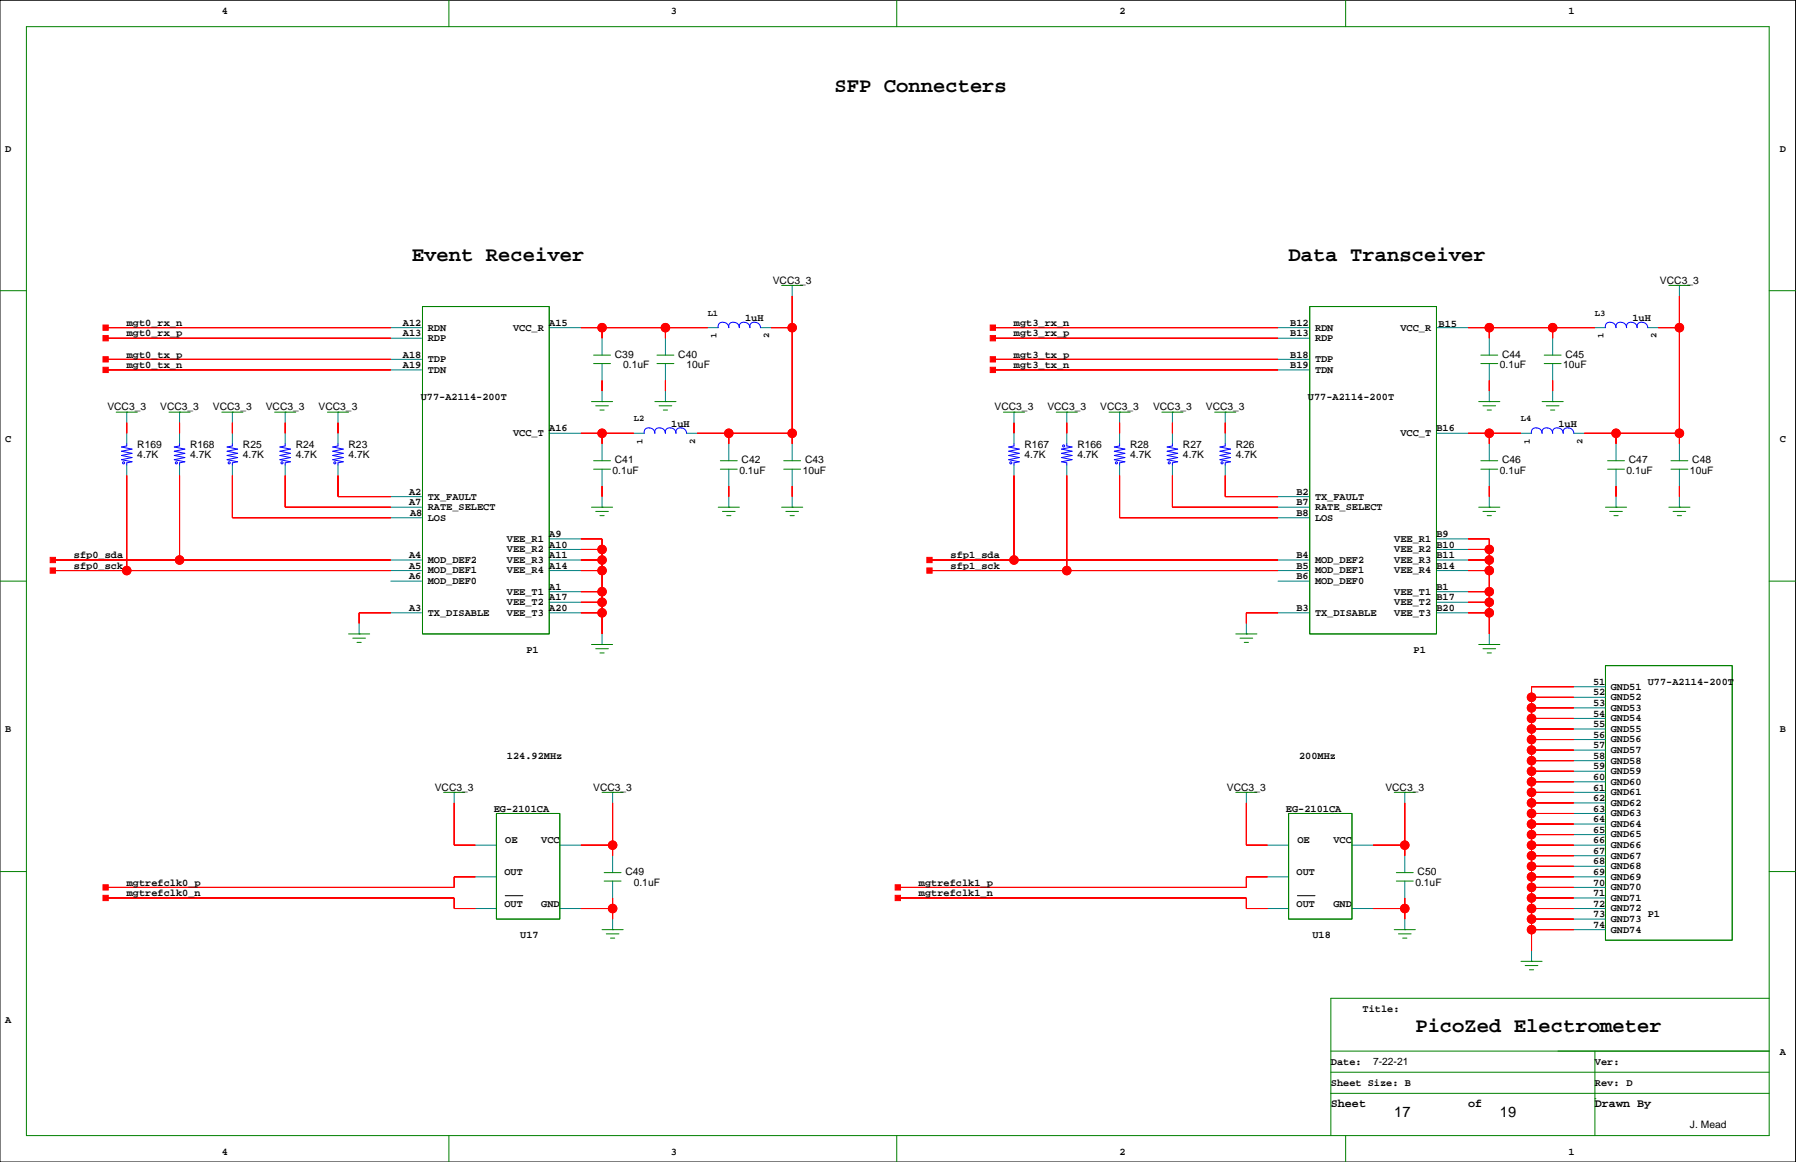
[picture p25: page 17]

# USB UART

# Zynq Peripherals : SDCARD / UART

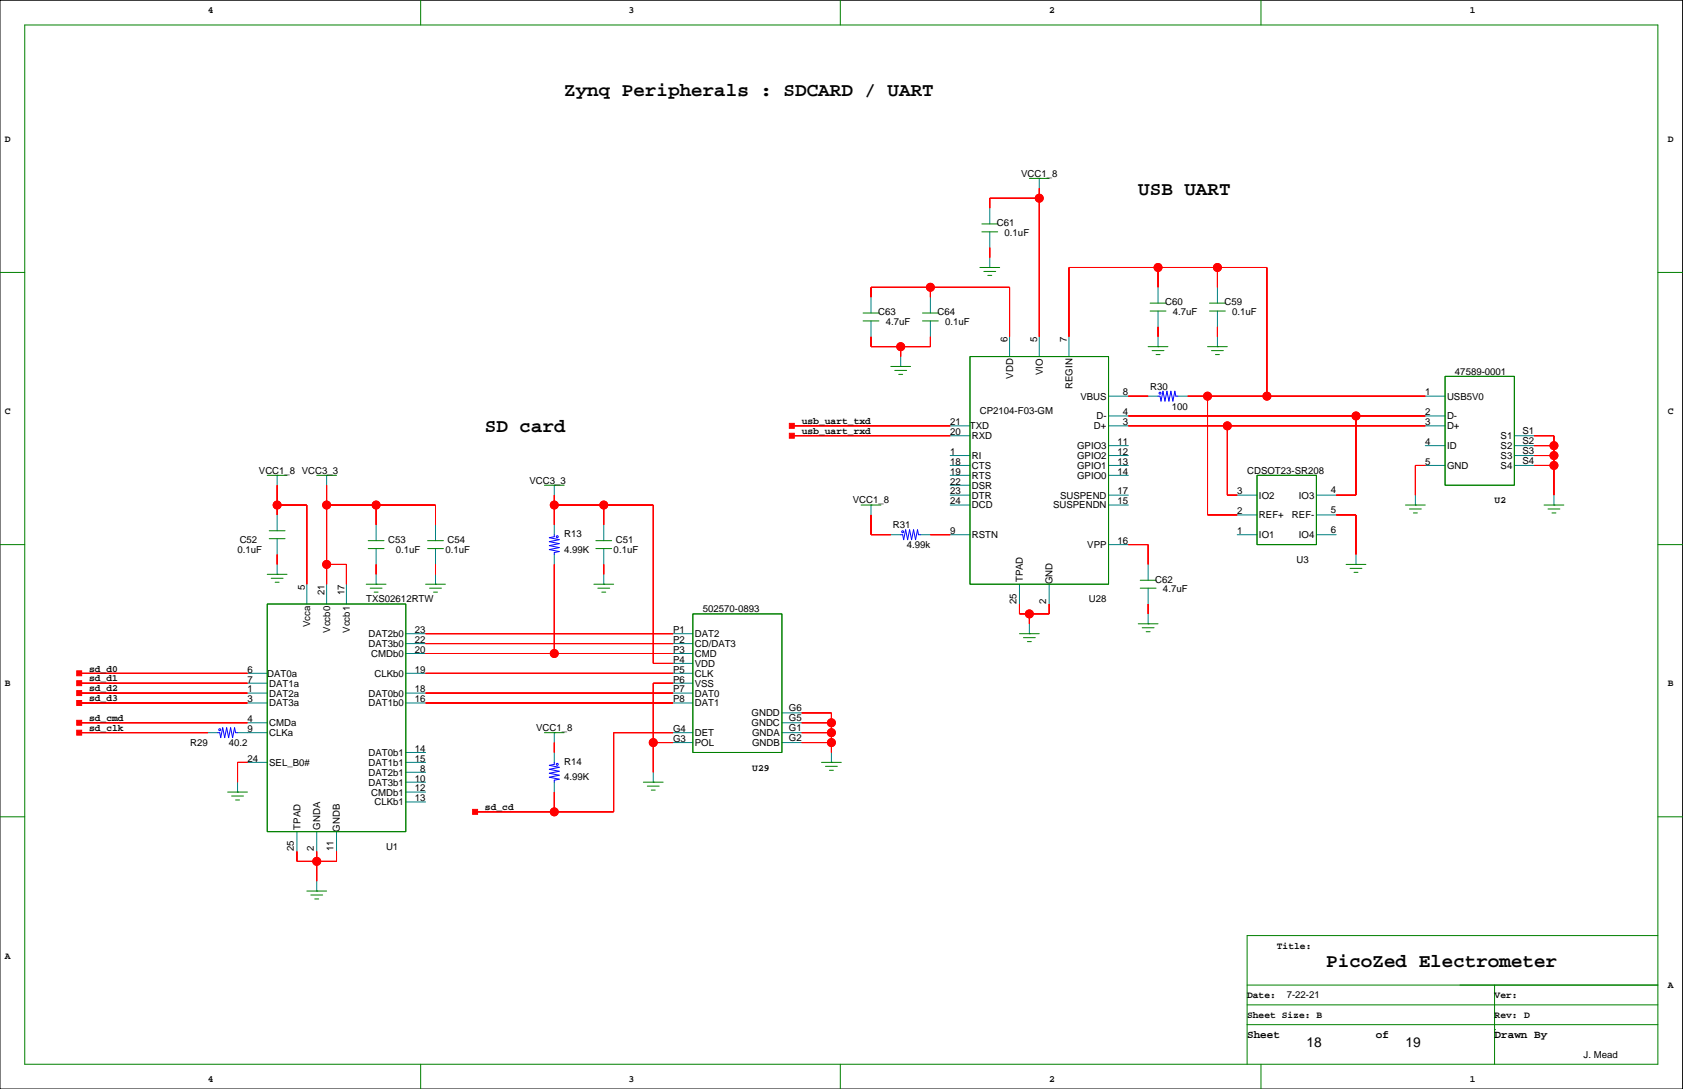
[picture p26: page 18]

# Zynq Peripherals : Gigabit Ethernet / USB

### MAGNETICS

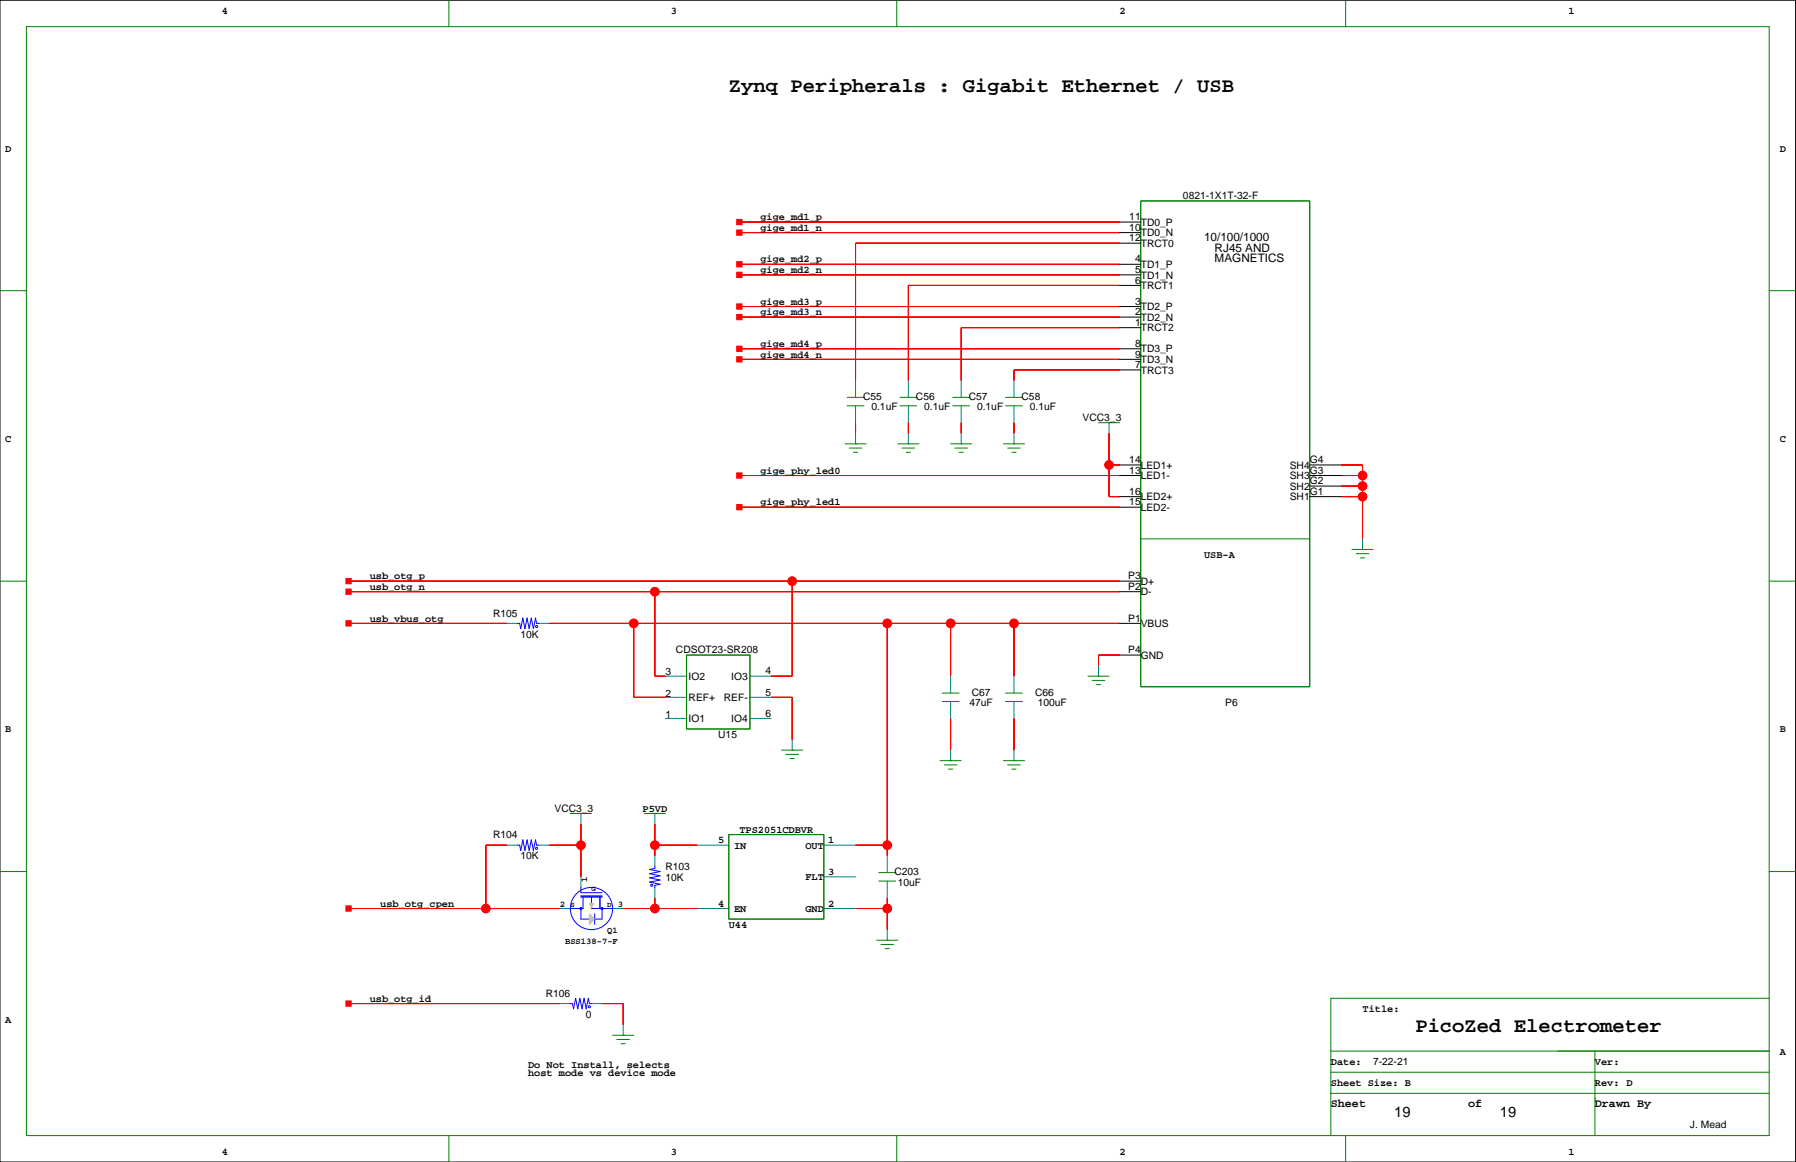
[picture p27: page 19]

Do Not Install, selects
host mode vs device mode
