NSLS-II/nsls2em-fpga/src/hw/cstr/pins.xdc

# Front End Channel 0
set_property PACKAGE_PIN H3 [get_ports {adc_sck[0]}]
set_property IOSTANDARD LVCMOS18 [get_ports {adc_sck[0]}]
set_property PACKAGE_PIN H4 [get_ports {adc_cnv[0]}]
set_property IOSTANDARD LVCMOS18 [get_ports {adc_cnv[0]}]
set_property PACKAGE_PIN E5 [get_ports {adc_sdo[0]}]
set_property IOSTANDARD LVCMOS18 [get_ports {adc_sdo[0]}]
set_property PACKAGE_PIN F5 [get_ports {adc_busy[0]}]
set_property IOSTANDARD LVCMOS18 [get_ports {adc_busy[0]}]

set_property PACKAGE_PIN G3 [get_ports {afe_lat[0]}]
set_property IOSTANDARD LVCMOS18 [get_ports {afe_lat[0]}]
set_property PACKAGE_PIN G2 [get_ports {afe_sdi[0]}]
set_property IOSTANDARD LVCMOS18 [get_ports {afe_sdi[0]}]
set_property PACKAGE_PIN F2 [get_ports {afe_cs[0]}]
set_property IOSTANDARD LVCMOS18 [get_ports {afe_cs[0]}]
set_property PACKAGE_PIN F1 [get_ports {afe_sck[0]}]
set_property IOSTANDARD LVCMOS18 [get_ports {afe_sck[0]}]



# Front End Channel 1
set_property PACKAGE_PIN F4 [get_ports {adc_sck[1]}]
set_property IOSTANDARD LVCMOS18 [get_ports {adc_sck[1]}]
set_property PACKAGE_PIN G4 [get_ports {adc_cnv[1]}]
set_property IOSTANDARD LVCMOS18 [get_ports {adc_cnv[1]}]
set_property PACKAGE_PIN E3 [get_ports {adc_sdo[1]}]
set_property IOSTANDARD LVCMOS18 [get_ports {adc_sdo[1]}]
set_property PACKAGE_PIN E4 [get_ports {adc_busy[1]}]
set_property IOSTANDARD LVCMOS18 [get_ports {adc_busy[1]}]

set_property PACKAGE_PIN G6 [get_ports {afe_lat[1]}]
set_property IOSTANDARD LVCMOS18 [get_ports {afe_lat[1]}]
set_property PACKAGE_PIN F6 [get_ports {afe_sdi[1]}]
set_property IOSTANDARD LVCMOS18 [get_ports {afe_sdi[1]}]
set_property PACKAGE_PIN B2 [get_ports {afe_cs[1]}]
set_property IOSTANDARD LVCMOS18 [get_ports {afe_cs[1]}]
set_property PACKAGE_PIN B1 [get_ports {afe_sck[1]}]
set_property IOSTANDARD LVCMOS18 [get_ports {afe_sck[1]}]


# Front End Channel 2
set_property PACKAGE_PIN C5 [get_ports {adc_sck[2]}]
set_property IOSTANDARD LVCMOS18 [get_ports {adc_sck[2]}]
set_property PACKAGE_PIN C6 [get_ports {adc_cnv[2]}]
set_property IOSTANDARD LVCMOS18 [get_ports {adc_cnv[2]}]
set_property PACKAGE_PIN C4 [get_ports {adc_sdo[2]}]
set_property IOSTANDARD LVCMOS18 [get_ports {adc_sdo[2]}]
set_property PACKAGE_PIN D5 [get_ports {adc_busy[2]}]
set_property IOSTANDARD LVCMOS18 [get_ports {adc_busy[2]}]

set_property PACKAGE_PIN B4 [get_ports {afe_lat[2]}]
set_property IOSTANDARD LVCMOS18 [get_ports {afe_lat[2]}]
set_property PACKAGE_PIN B3 [get_ports {afe_sdi[2]}]
set_property IOSTANDARD LVCMOS18 [get_ports {afe_sdi[2]}]
set_property PACKAGE_PIN D3 [get_ports {afe_cs[2]}]
set_property IOSTANDARD LVCMOS18 [get_ports {afe_cs[2]}]
set_property PACKAGE_PIN C3 [get_ports {afe_sck[2]}]
set_property IOSTANDARD LVCMOS18 [get_ports {afe_sck[2]}]



# Front End Channel 3
set_property PACKAGE_PIN D2 [get_ports {adc_sck[3]}]
set_property IOSTANDARD LVCMOS18 [get_ports {adc_sck[3]}]
set_property PACKAGE_PIN E2 [get_ports {adc_cnv[3]}]
set_property IOSTANDARD LVCMOS18 [get_ports {adc_cnv[3]}]
set_property PACKAGE_PIN D6 [get_ports {adc_sdo[3]}]
set_property IOSTANDARD LVCMOS18 [get_ports {adc_sdo[3]}]
set_property PACKAGE_PIN D7 [get_ports {adc_busy[3]}]
set_property IOSTANDARD LVCMOS18 [get_ports {adc_busy[3]}]

set_property PACKAGE_PIN F7 [get_ports {afe_lat[3]}]
set_property IOSTANDARD LVCMOS18 [get_ports {afe_lat[3]}]
set_property PACKAGE_PIN E7 [get_ports {afe_sdi[3]}]
set_property IOSTANDARD LVCMOS18 [get_ports {afe_sdi[3]}]
set_property PACKAGE_PIN A5 [get_ports {afe_cs[3]}]
set_property IOSTANDARD LVCMOS18 [get_ports {afe_cs[3]}]
set_property PACKAGE_PIN A4 [get_ports {afe_sck[3]}]
set_property IOSTANDARD LVCMOS18 [get_ports {afe_sck[3]}]



# Front End Channel 4 (daughterboard)
set_property PACKAGE_PIN M3 [get_ports {adc_sck[4]}]
set_property IOSTANDARD LVCMOS18 [get_ports {adc_sck[4]}]
set_property PACKAGE_PIN M4 [get_ports {adc_cnv[4]}]
set_property IOSTANDARD LVCMOS18 [get_ports {adc_cnv[4]}]
set_property PACKAGE_PIN J1 [get_ports {adc_sdo[4]}]
set_property IOSTANDARD LVCMOS18 [get_ports {adc_sdo[4]}]
set_property PACKAGE_PIN J2 [get_ports {adc_busy[4]}]
set_property IOSTANDARD LVCMOS18 [get_ports {adc_busy[4]}]

set_property PACKAGE_PIN K7 [get_ports {afe_gain[0]}]
set_property IOSTANDARD LVCMOS18 [get_ports {afe_gain[0]}]
set_property PACKAGE_PIN L7 [get_ports {afe_gain[1]}]
set_property IOSTANDARD LVCMOS18 [get_ports {afe_gain[1]}]



# Front End Channel 5 (daughterboard)
set_property PACKAGE_PIN R7 [get_ports {adc_sck[5]}]
set_property IOSTANDARD LVCMOS18 [get_ports {adc_sck[5]}]
set_property PACKAGE_PIN P7 [get_ports {adc_cnv[5]}]
set_property IOSTANDARD LVCMOS18 [get_ports {adc_cnv[5]}]
set_property PACKAGE_PIN L1 [get_ports {adc_sdo[5]}]
set_property IOSTANDARD LVCMOS18 [get_ports {adc_sdo[5]}]
set_property PACKAGE_PIN L2 [get_ports {adc_busy[5]}]
set_property IOSTANDARD LVCMOS18 [get_ports {adc_busy[5]}]

set_property PACKAGE_PIN N4 [get_ports {afe_gain[2]}]
set_property IOSTANDARD LVCMOS18 [get_ports {afe_gain[2]}]
set_property PACKAGE_PIN N3 [get_ports {afe_gain[3]}]
set_property IOSTANDARD LVCMOS18 [get_ports {afe_gain[3]}]



# Front End Channel 6 (daughterboard)
set_property PACKAGE_PIN M1 [get_ports {adc_sck[6]}]
set_property IOSTANDARD LVCMOS18 [get_ports {adc_sck[6]}]
set_property PACKAGE_PIN M2 [get_ports {adc_cnv[6]}]
set_property IOSTANDARD LVCMOS18 [get_ports {adc_cnv[6]}]
set_property PACKAGE_PIN P1 [get_ports {adc_sdo[6]}]
set_property IOSTANDARD LVCMOS18 [get_ports {adc_sdo[6]}]
set_property PACKAGE_PIN N1 [get_ports {adc_busy[6]}]
set_property IOSTANDARD LVCMOS18 [get_ports {adc_busy[6]}]

set_property PACKAGE_PIN K4 [get_ports {afe_gain[4]}]
set_property IOSTANDARD LVCMOS18 [get_ports {afe_gain[4]}]
set_property PACKAGE_PIN K3 [get_ports {afe_gain[5]}]
set_property IOSTANDARD LVCMOS18 [get_ports {afe_gain[5]}]


# Front End Channel 7 (daughterboard)
set_property PACKAGE_PIN R2 [get_ports {adc_sck[7]}]
set_property IOSTANDARD LVCMOS18 [get_ports {adc_sck[7]}]
set_property PACKAGE_PIN R3 [get_ports {adc_cnv[7]}]
set_property IOSTANDARD LVCMOS18 [get_ports {adc_cnv[7]}]
set_property PACKAGE_PIN M6 [get_ports {adc_sdo[7]}]
set_property IOSTANDARD LVCMOS18 [get_ports {adc_sdo[7]}]
set_property PACKAGE_PIN L6 [get_ports {adc_busy[7]}]
set_property IOSTANDARD LVCMOS18 [get_ports {adc_busy[7]}]

set_property PACKAGE_PIN J5 [get_ports {afe_gain[6]}]
set_property IOSTANDARD LVCMOS18 [get_ports {afe_gain[6]}]
set_property PACKAGE_PIN K5 [get_ports {afe_gain[7]}]
set_property IOSTANDARD LVCMOS18 [get_ports {afe_gain[7]}]




# ad5060  BIAS DAC
set_property PACKAGE_PIN AB22 [get_ports biasdac_sclk]
set_property IOSTANDARD LVCMOS33 [get_ports biasdac_sclk]
set_property PACKAGE_PIN AB21 [get_ports biasdac_din]
set_property IOSTANDARD LVCMOS33 [get_ports biasdac_din]
set_property PACKAGE_PIN AA19 [get_ports biasdac_sync]
set_property IOSTANDARD LVCMOS33 [get_ports biasdac_sync]




# Motor Control Feedback DAC
set_property PACKAGE_PIN U19 [get_ports fdbkdac_syncn]
set_property IOSTANDARD LVCMOS33 [get_ports fdbkdac_syncn]
set_property DRIVE 12 [get_ports fdbkdac_syncn]
set_property SLEW SLOW [get_ports fdbkdac_syncn]

set_property PACKAGE_PIN AA15 [get_ports fdbkdac_sclk]
set_property IOSTANDARD LVCMOS33 [get_ports fdbkdac_sclk]
set_property DRIVE 12 [get_ports fdbkdac_sclk]
set_property SLEW SLOW [get_ports fdbkdac_sclk]

set_property PACKAGE_PIN AA14 [get_ports fdbkdac_sdin]
set_property IOSTANDARD LVCMOS33 [get_ports fdbkdac_sdin]
set_property DRIVE 12 [get_ports fdbkdac_sdin]
set_property SLEW SLOW [get_ports fdbkdac_sdin]

set_property PACKAGE_PIN Y15 [get_ports fdbkdac_sdo]
set_property IOSTANDARD LVCMOS33 [get_ports fdbkdac_sdo]


set_property PACKAGE_PIN V19 [get_ports fdbkdac_ldacn]
set_property IOSTANDARD LVCMOS33 [get_ports fdbkdac_ldacn]
set_property DRIVE 12 [get_ports fdbkdac_ldacn]
set_property SLEW SLOW [get_ports fdbkdac_ldacn]

set_property PACKAGE_PIN Y14 [get_ports fdbkdac_clrn]
set_property IOSTANDARD LVCMOS33 [get_ports fdbkdac_clrn]
set_property DRIVE 12 [get_ports fdbkdac_clrn]
set_property SLEW SLOW [get_ports fdbkdac_clrn]

set_property PACKAGE_PIN V18 [get_ports fdbkdac_bin2s]
set_property IOSTANDARD LVCMOS33 [get_ports fdbkdac_bin2s]
set_property DRIVE 12 [get_ports fdbkdac_bin2s]
set_property SLEW SLOW [get_ports fdbkdac_bin2s]


# Heat Control DAC
set_property PACKAGE_PIN AA11 [get_ports heatdac_syncn]
set_property IOSTANDARD LVCMOS33 [get_ports heatdac_syncn]
set_property DRIVE 12 [get_ports heatdac_syncn]
set_property SLEW SLOW [get_ports heatdac_syncn]

set_property PACKAGE_PIN Y19 [get_ports heatdac_sclk]
set_property IOSTANDARD LVCMOS33 [get_ports heatdac_sclk]
set_property DRIVE 12 [get_ports heatdac_sclk]
set_property SLEW SLOW [get_ports heatdac_sclk]

set_property PACKAGE_PIN Y18 [get_ports heatdac_sdin]
set_property IOSTANDARD LVCMOS33 [get_ports heatdac_sdin]
set_property DRIVE 12 [get_ports heatdac_sdin]
set_property SLEW SLOW [get_ports heatdac_sdin]

set_property PACKAGE_PIN AB19 [get_ports heatdac_sdo]
set_property IOSTANDARD LVCMOS33 [get_ports heatdac_sdo]


set_property PACKAGE_PIN AB11 [get_ports heatdac_ldacn]
set_property IOSTANDARD LVCMOS33 [get_ports heatdac_ldacn]
set_property DRIVE 12 [get_ports heatdac_ldacn]
set_property SLEW SLOW [get_ports heatdac_ldacn]

set_property PACKAGE_PIN AB18 [get_ports heatdac_clrn]
set_property IOSTANDARD LVCMOS33 [get_ports heatdac_clrn]
set_property DRIVE 12 [get_ports heatdac_clrn]
set_property SLEW SLOW [get_ports heatdac_clrn]

set_property PACKAGE_PIN T16 [get_ports heatdac_bin2s]
set_property IOSTANDARD LVCMOS33 [get_ports heatdac_bin2s]
set_property DRIVE 12 [get_ports heatdac_bin2s]
set_property SLEW SLOW [get_ports heatdac_bin2s]






# Debug Header

set_property PACKAGE_PIN T2 [get_ports {dbg[0]}]
set_property IOSTANDARD LVCMOS18 [get_ports {dbg[0]}]
set_property DRIVE 12 [get_ports {dbg[0]}]
set_property SLEW SLOW [get_ports {dbg[0]}]

set_property PACKAGE_PIN T1 [get_ports {dbg[1]}]
set_property IOSTANDARD LVCMOS18 [get_ports {dbg[1]}]
set_property DRIVE 12 [get_ports {dbg[1]}]
set_property SLEW SLOW [get_ports {dbg[1]}]

set_property PACKAGE_PIN U2 [get_ports {dbg[2]}]
set_property IOSTANDARD LVCMOS18 [get_ports {dbg[2]}]
set_property DRIVE 12 [get_ports {dbg[2]}]
set_property SLEW SLOW [get_ports {dbg[2]}]

set_property PACKAGE_PIN U1 [get_ports {dbg[3]}]
set_property IOSTANDARD LVCMOS18 [get_ports {dbg[3]}]
set_property DRIVE 12 [get_ports {dbg[3]}]
set_property SLEW SLOW [get_ports {dbg[3]}]

set_property PACKAGE_PIN J7 [get_ports {dbg[4]}]
set_property IOSTANDARD LVCMOS18 [get_ports {dbg[4]}]
set_property DRIVE 12 [get_ports {dbg[4]}]
set_property SLEW SLOW [get_ports {dbg[4]}]

set_property PACKAGE_PIN J6 [get_ports {dbg[5]}]
set_property IOSTANDARD LVCMOS18 [get_ports {dbg[5]}]
set_property DRIVE 12 [get_ports {dbg[5]}]
set_property SLEW SLOW [get_ports {dbg[5]}]

set_property PACKAGE_PIN J8 [get_ports {dbg[6]}]
set_property IOSTANDARD LVCMOS18 [get_ports {dbg[6]}]
set_property DRIVE 12 [get_ports {dbg[6]}]
set_property SLEW SLOW [get_ports {dbg[6]}]

set_property PACKAGE_PIN K8 [get_ports {dbg[7]}]
set_property IOSTANDARD LVCMOS18 [get_ports {dbg[7]}]
set_property DRIVE 12 [get_ports {dbg[7]}]
set_property SLEW SLOW [get_ports {dbg[7]}]

set_property PACKAGE_PIN M8 [get_ports {dbg[8]}]
set_property IOSTANDARD LVCMOS18 [get_ports {dbg[8]}]
set_property DRIVE 12 [get_ports {dbg[8]}]
set_property SLEW SLOW [get_ports {dbg[8]}]

set_property PACKAGE_PIN M7 [get_ports {dbg[9]}]
set_property IOSTANDARD LVCMOS18 [get_ports {dbg[9]}]
set_property DRIVE 12 [get_ports {dbg[9]}]
set_property SLEW SLOW [get_ports {dbg[9]}]



#fp LEDS
set_property PACKAGE_PIN P6 [get_ports {fp_leds[0]}]
set_property IOSTANDARD LVCMOS18 [get_ports {fp_leds[0]}]
set_property DRIVE 12 [get_ports {fp_leds[0]}]
set_property SLEW SLOW [get_ports {fp_leds[0]}]

set_property PACKAGE_PIN P5 [get_ports {fp_leds[1]}]
set_property IOSTANDARD LVCMOS18 [get_ports {fp_leds[1]}]
set_property DRIVE 12 [get_ports {fp_leds[1]}]
set_property SLEW SLOW [get_ports {fp_leds[1]}]

set_property PACKAGE_PIN N8 [get_ports {fp_leds[2]}]
set_property IOSTANDARD LVCMOS18 [get_ports {fp_leds[2]}]
set_property DRIVE 12 [get_ports {fp_leds[2]}]
set_property SLEW SLOW [get_ports {fp_leds[2]}]


set_property PACKAGE_PIN P8 [get_ports {fp_leds[3]}]
set_property IOSTANDARD LVCMOS18 [get_ports {fp_leds[3]}]
set_property DRIVE 12 [get_ports {fp_leds[3]}]
set_property SLEW SLOW [get_ports {fp_leds[3]}]





# SFP I2C
set_property PACKAGE_PIN V11 [get_ports {sfp_sck[0]}]
set_property IOSTANDARD LVCMOS33 [get_ports {sfp_sck[0]}]
set_property PACKAGE_PIN W11 [get_ports {sfp_sda[0]}]
set_property IOSTANDARD LVCMOS33 [get_ports {sfp_sda[0]}]

set_property PACKAGE_PIN W12 [get_ports {sfp_sck[1]}]
set_property IOSTANDARD LVCMOS33 [get_ports {sfp_sck[1]}]
set_property PACKAGE_PIN W13 [get_ports {sfp_sda[1]}]
set_property IOSTANDARD LVCMOS33 [get_ports {sfp_sda[1]}]


# fan tach and pwm
set_property PACKAGE_PIN N6 [get_ports fan_tach]
set_property IOSTANDARD LVCMOS18 [get_ports fan_tach]

set_property PACKAGE_PIN C8 [get_ports fan_i2c_sda]
set_property IOSTANDARD LVCMOS18 [get_ports fan_i2c_sda]
set_property DRIVE 12 [get_ports fan_i2c_sda]
set_property SLEW SLOW [get_ports fan_i2c_sda]

set_property PACKAGE_PIN B8 [get_ports fan_i2c_scl]
set_property IOSTANDARD LVCMOS18 [get_ports fan_i2c_scl]
set_property DRIVE 12 [get_ports fan_i2c_scl]
set_property SLEW SLOW [get_ports fan_i2c_scl]



# voltage, current and temp i2c
set_property PACKAGE_PIN A7 [get_ports ivt_i2c_sda]
set_property IOSTANDARD LVCMOS18 [get_ports ivt_i2c_sda]
set_property DRIVE 12 [get_ports ivt_i2c_sda]
set_property SLEW SLOW [get_ports ivt_i2c_sda]

set_property PACKAGE_PIN A6 [get_ports ivt_i2c_scl]
set_property IOSTANDARD LVCMOS18 [get_ports ivt_i2c_scl]
set_property DRIVE 12 [get_ports ivt_i2c_scl]
set_property SLEW SLOW [get_ports ivt_i2c_scl]



# GPIO
set_property PACKAGE_PIN AA16 [get_ports {gpio_in[0]}]
set_property IOSTANDARD LVCMOS33 [get_ports {gpio_in[0]}]

set_property PACKAGE_PIN AA17 [get_ports {gpio_in[1]}]
set_property IOSTANDARD LVCMOS33 [get_ports {gpio_in[1]}]

set_property PACKAGE_PIN Y12 [get_ports {gpio_in[2]}]
set_property IOSTANDARD LVCMOS33 [get_ports {gpio_in[2]}]

set_property PACKAGE_PIN Y13 [get_ports {gpio_in[3]}]
set_property IOSTANDARD LVCMOS33 [get_ports {gpio_in[3]}]


set_property PACKAGE_PIN V13 [get_ports {gpio_out[0]}]
set_property IOSTANDARD LVCMOS33 [get_ports {gpio_out[0]}]

set_property PACKAGE_PIN V14 [get_ports {gpio_out[1]}]
set_property IOSTANDARD LVCMOS33 [get_ports {gpio_out[1]}]

set_property PACKAGE_PIN R17 [get_ports {gpio_out[2]}]
set_property IOSTANDARD LVCMOS33 [get_ports {gpio_out[2]}]

set_property PACKAGE_PIN T17 [get_ports {gpio_out[3]}]
set_property IOSTANDARD LVCMOS33 [get_ports {gpio_out[3]}]



# Thermistor Readback  LTC2986
set_property PACKAGE_PIN V16 [get_ports therm_sclk]
set_property IOSTANDARD LVCMOS33 [get_ports therm_sclk]

set_property PACKAGE_PIN W16 [get_ports therm_sdo]
set_property IOSTANDARD LVCMOS33 [get_ports therm_sdo]

set_property PACKAGE_PIN W15 [get_ports therm_sdi]
set_property IOSTANDARD LVCMOS33 [get_ports therm_sdi]

set_property PACKAGE_PIN V15 [get_ports therm_csn]
set_property IOSTANDARD LVCMOS33 [get_ports therm_csn]

set_property PACKAGE_PIN W18 [get_ports therm_rstn]
set_property IOSTANDARD LVCMOS33 [get_ports therm_rstn]
