NSLS-II/nsls2em-fpga/src/hw/cstr/gtx.xdc

create_clock -period 3.200 [get_ports gtx_evr_refclk_p]
create_clock -period 8.000 [get_ports gtx_fofb_refclk_p]


#MGTREFCLK1 - U18  (312.5MHz)
set_property PACKAGE_PIN U5 [get_ports gtx_evr_refclk_p]
set_property PACKAGE_PIN V5 [get_ports gtx_evr_refclk_n]


#MGTREFCLK0 - U17  (125MHz)
set_property PACKAGE_PIN U9 [get_ports gtx_fofb_refclk_p]
set_property PACKAGE_PIN V9 [get_ports gtx_fofb_refclk_n]

#

################################# mgt wrapper constraints #####################

##---------- Set placement for gt0_gtx_wrapper_i/GTXE2_CHANNEL ------

set_property LOC GTXE2_CHANNEL_X0Y3 [get_cells evr/evr_gtx_init_i/U0/evr_gtx_i/gt0_evr_gtx_i/gtxe2_i]

set_property LOC GTXE2_CHANNEL_X0Y0 [get_cells fofb/fofb_gtx_init_i/U0/fofb_gtx_i/gt0_fofb_gtx_i/gtxe2_i]
