NSLS-II/nsls2em-fpga/(commit log)

2024-12-29 Add basic FWK files
    [default.cfg, hw.cfg, sw.cfg]
2024-12-31 Add Vitis hello_world program
    [sw.cfg]
2024-12-31 Add PSC threads
    [sw.cfg]
2025-01-03 Add printouts of ADC and SA data in main for debug
2025-01-04 Add Yuke Vitis project in sw-dssi, testing vitis project moved to sw-diag
    [sw-diag.cfg, sw-dssi.cfg]
2025-01-07 Fix FPGA version readback register
    [dataProcess.c, iobus.h, main.c, nsls2em.h, ps_io.vhd]
